loglow/TinyNES/README.md

# TinyNES
Classic NES games on open source hardware that fits in the palm of your hand

This work is licensed under a [Creative Commons Attribution-ShareAlike 4.0 International License](http://creativecommons.org/licenses/by-sa/4.0/).
