loglow/TinyNES/Packaging/TinyNES_Cart_Latch_Label.png

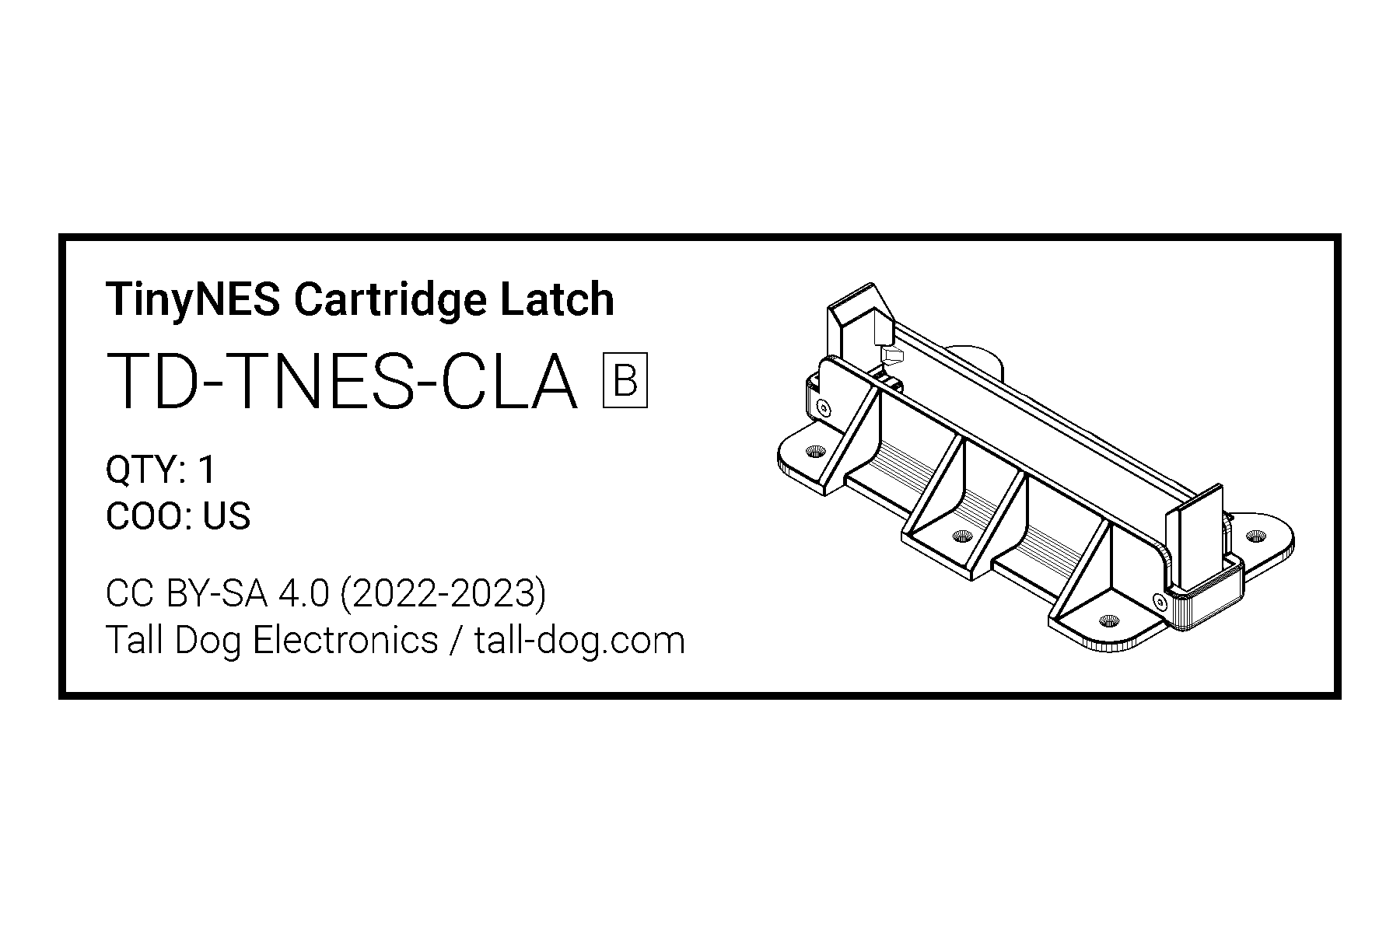
Packaging/TinyNES_Cart_Latch_Label.png
