loglow/TinyNES/Packaging/TinyNES_Famicom_Adapter_Label.png

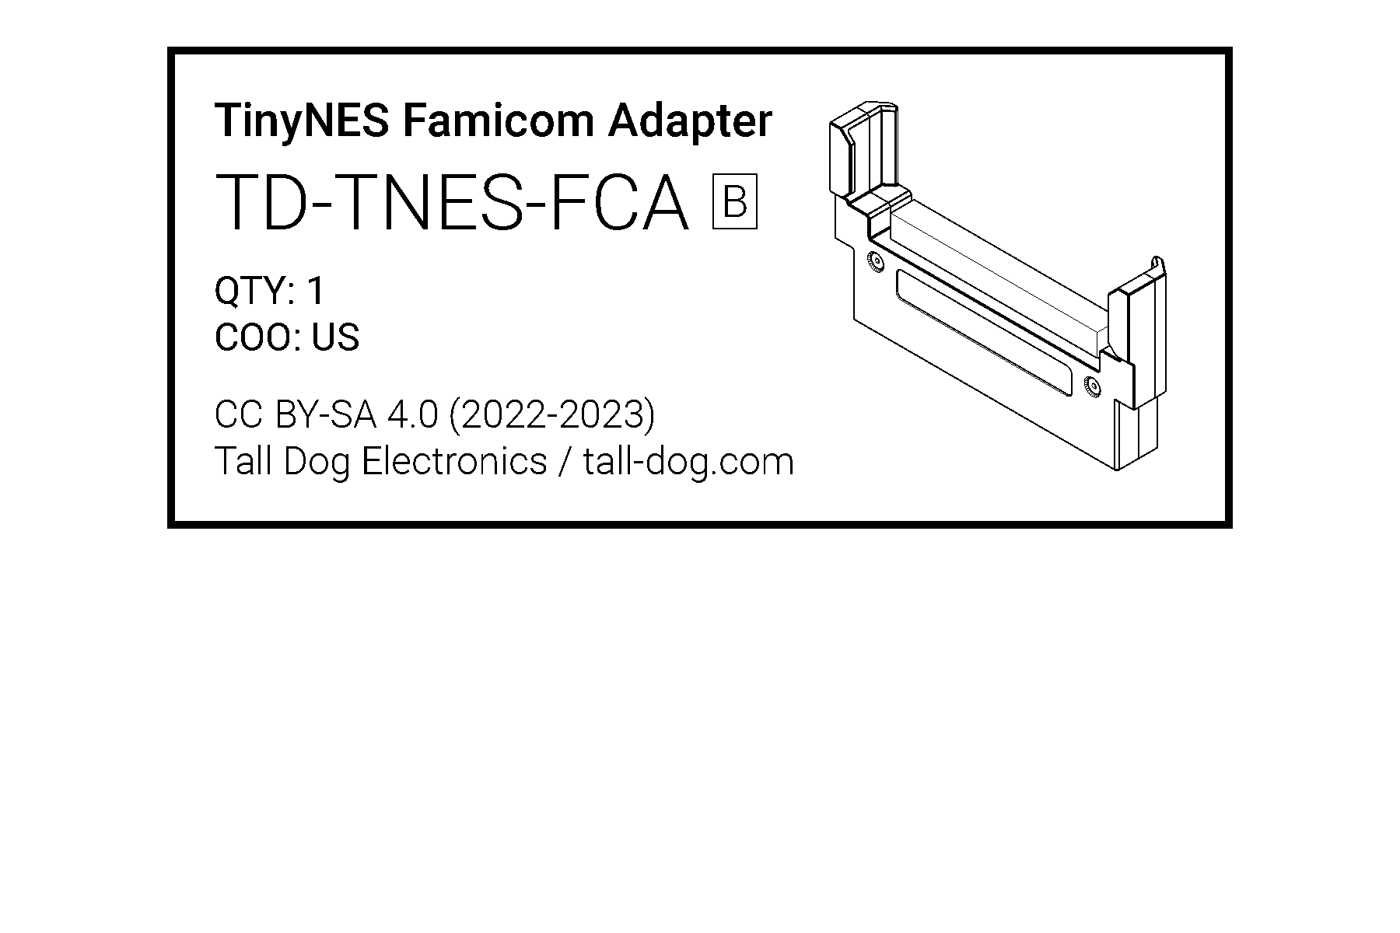
Packaging/TinyNES_Famicom_Adapter_Label.png
