loglow/TinyNES/Main Board/TinyNES_Main_Board_BOM.csv

Ref | Qty | Desc | Mfg | MPN
C1 C5 C11 C12 C13 | 5 | CAP CER 1UF 10V X7R 0805 | Samsung Electro-Mechanics | CL21B105KPFNNNE
C2 C3 C6 C7 C8 C9 C14 C17 C18 C24 C33 C38 | 12 | CAP CER 0.1UF 50V X7R 0805 | Samsung Electro-Mechanics | CL21B104KBCNNNC
C4 | 1 | CAP CER 10000PF 50V X7R 0805 | Samsung Electro-Mechanics | CL21B103KBANNNC
C10 C16 | 2 | CAP FILM 0.47UF 20% 16VDC 1206 | Panasonic Electronic Components | ECP-U1C474MA5
C15 | 1 | CAP ALUM 10UF 20% 16V SMD | Würth Elektronik | 865080340001
C19 C20 C21 C23 C26 C30 C34 C37 C39 | 9 | CAP CER 330PF 50V C0G/NPO 0805 | YAGEO | CC0805JRNPO9BN331
C22 | 1 | CAP TANT 10UF 10% 16V 1206 | KYOCERA AVX | TAJA106K016RNJ
C25 | 1 | DO NOT POPULATE | DNP | DNP
C27 C28 C29 | 3 | CAP FILM 1UF 20% 16VDC 1210 | Panasonic Electronic Components | ECP-U1C105MA5
C31 | 1 | CAP ALUM 220UF 20% 10V SMD | Nichicon | UWX1A221MCL1GB
C32 | 1 | CAP ALUM 100UF 20% 10V SMD | Panasonic Electronic Components | EEE-HA1A101WP
C35 | 1 | CAP CER 560PF 50V C0G/NPO 0805 | YAGEO | CC0805JRNPO9BN561
C36 | 1 | CAP CER 4.7UF 16V X7R 0805 | Murata Electronics | GRM21BR71C475KE51L
D1 | 1 | LED COOL WHITE CLEAR 5MM T/H | CreeLED, Inc. | C535A-WJN-CU0W0231
DA1 DA3 | 2 | DIODE ARRAY GP 80V 100MA UMD6 | Rohm Semiconductor | UMP11NTN
DA2 DA4 | 2 | DIODE ARRAY GP 80V 100MA UMD6 | Rohm Semiconductor | UMN11NTN
DA5 | 1 | DIODE ARRAY GP 180V 200MA SOT23 | Micro Commercial Co | MMBD1503-TP
H1 | 1 | CONN CARDEDGE 72POS 2.50MM | Xunbeifang | GNI06700
H2 H3 H4 | 3 | CONN RCPT 3POS 0.1 GOLD PCB | Samtec Inc. | SLW-103-01-F-S
H5 H6 | 2 | CONN HEADER VERT 7POS 2MM | Adam Tech | 2SH-C-07-TS
J1 | 1 | CONN RCA JACK MONO 3.2MM R/A | CUI Devices | RCJ-044
J2 | 1 | CONN RCA JACK MONO 3.2MM R/A | CUI Devices | RCJ-042
J3 | 1 | CONN JACK 4COND 3.5MM R/A | CUI Devices | SJ-43514
J4 | 1 | CONN RCPT TYPE C 6P SMD RA | GCT | USB4125-GF-A
P1 | 1 | TRIM 100K OHM 0.5W GW TOP ADJ | Bourns Inc. | 3361P-1-104GLF
Q1 | 1 | TRANS PNP 40V 200MA TO236AB | Nexperia USA Inc. | PMBT3906,235
R1 | 1 | RES 100K OHM 1% 1/8W 0805 | Stackpole Electronics Inc | RMCF0805FT100K
R2 R15 R16 R17 R18 | 5 | RES 10K OHM 1% 1/8W 0805 | YAGEO | RC0805FR-0710KL
R3 R4 R5 | 3 | RES 30 OHM 1% 1/8W 0805 | YAGEO | RC0805FR-0730RL
R6 R11 | 2 | RES 12K OHM 0.5% 1/8W 0805 | Panasonic Electronic Components | ERA-6AED123V
R7 R9 | 2 | RES 68 OHM 1% 1/8W 0805 | YAGEO | RT0805FRE0768RL
R8 | 1 | RES 20K OHM 1% 1/4W 0805 | Stackpole Electronics Inc | RNCP0805FTD20K0
R10 R12 R13 | 3 | RES 22K OHM 1% 1/8W 0805 | YAGEO | RT0805FRE0722KL
R14 | 1 | RES 80.6K OHM 0.1% 1/8W 0805 | Panasonic Electronic Components | ERA-6AEB8062V
R19 | 1 | RES 300 OHM 1% 1/8W 0805 | YAGEO | RC0805FR-07300RL
R20 | 1 | RES 270 OHM 1% 1/8W 0805 | YAGEO | RC0805FR-07270RL
R21 | 1 | RES 110 OHM 5% 1/8W 0805 | Panasonic Electronic Components | ERJ-6GEYJ111V
R22 | 1 | RES 150 OHM 0.1% 1/8W 0805 | YAGEO | RT0805BRD07150RL
R23 R24 | 2 | RES 5.1K OHM 1% 1/8W 0805 | YAGEO | RC0805FR-075K1L
R25 R26 R27 R28 | 4 | RES 10K OHM 1% 1/10W 0603 | YAGEO | RC0603FR-0710KL
RA1 | 1 | RES ARRAY 8 RES 10K OHM 2512 | Panasonic Electronic Components | EXB-A10P103J
S1 S2 | 2 | SWITCH SLIDE DPDT 300MA 6V | C&K | JS202011JCQN
S3 | 1 | SWITCH TACTILE SPST-NO 0.05A 12V | C&K | PTS645VH83-2 LFS
S4 | 1 | SWITCH SLIDE SPDT 200MA 30V | E-Switch | EG1213
S5 | 1 | SWITCH SLIDE SPDT 300MA 4V | Nidec Copal Electronics | CUS-12TB
U1 U4 U18 | 3 | IC BUFFER INVERT 5.5V SOT23-5 | Texas Instruments | SN74LVC1G240DBVT
U2 | 1 | IC MEMS OSC XO 26.601712MHZ SMD | SiTime | SIT2001BC-S2-33N-26.601712
U3 | 1 | IC CLK MULTIPLIER PLL 8-SOIC | Renesas Electronics America Inc | 501MLFT
U5 U6 | 2 | IC SRAM 256KBIT PARALLEL 28SOP | ISSI, Integrated Silicon Solution Inc | IS62C256AL-45ULI-TR
U7 | 1 | IC CLK BUFFER 1:3 150MHZ 6SOT23 | Microchip Technology | PL133-37TC
U8 | 1 | IC MEMS OSC XO 21.477270MHZ SMD | SiTime | SIT2001BC-S2-33N-21.477270
U9 | 1 | IC REG LINEAR 3.3V 300MA SOT23 | Diodes Incorporated | AP2127N-3.3TRG1
U10 U11 | 2 | IC FF D-TYPE SNGL 1BIT 8TSSOP | Nexperia USA Inc. | 74LVC1G74DP,125
U12 | 1 | IC LINE DRIVER 14TSSOP | onsemi | NCS603DTBR2G
U13 | 1 | IC LATCH TRANSP OCTAL D 20SO | Texas Instruments | SN74ALS373ANSR
U14 U16 | 2 | IC DIP SOCKET 40POS MACHINED GOLD | Phoenix Enterprises | HWS2632
U15 | 1 | IC DECODER/DEMUX 1X2:4 16SOIC | Texas Instruments | SN74LS139ADR
U17 | 1 | IC BUFFER INVERT 5.5V 20SO | Texas Instruments | SN74AHC240NSR
U19 | 1 | IC SUPERVISOR 1 CHANNEL SOT143 | Diodes Incorporated | APX811-46UG-7
U20 | 1 | IC PWR SWITCH P-CHAN 1:1 SOT23-5 | Microchip Technology | MIC2004-1.2YM5-TR
U21 | 1 | IC GATE NOR 1CH 2-INP 5TSOP | onsemi | MC74VHC1G02DTT1G
U22 | 1 | IC GATE XOR 1CH 2-INP 5TSOP | onsemi | MC74VHC1G86DTT1G
