loglow/TinyNES/Jumper Board/TinyNES_Jumper_Board_BOM.csv

Ref | Qty | Desc | Mfg | MPN
H1 H2 H3 | 3 | CONN HEADER VERT 3POS 2.54MM | Samtec Inc. | TSW-103-06-L-S
