loglow/TinyNES/Famicom Adapter/TinyNES_Famicom_Adapter_BOM.csv

Ref | Qty | Desc | Mfg | MPN
H1 | 1 | CARDEDGE FEMALE 60POS 2.54MM | WingTAT | S-60M-2.54-5
