loglow/TinyNES/RGB Board/TinyNES_RGB_Board_XYR.csv

Ref | X | Y | R
C1 | 34.93 | 8.13 | 180
C2 | 46.36 | 6.1 | 270
R1 | 40.64 | 4.06 | 90
R2 | 25.65 | 4.06 | 90
R3 | 16.51 | 4.06 | 270
U1 | 34.93 | 3.94 | 90
