loglow/TinyNES/Packaging/TinyNES_Foam_Cutout_A.step

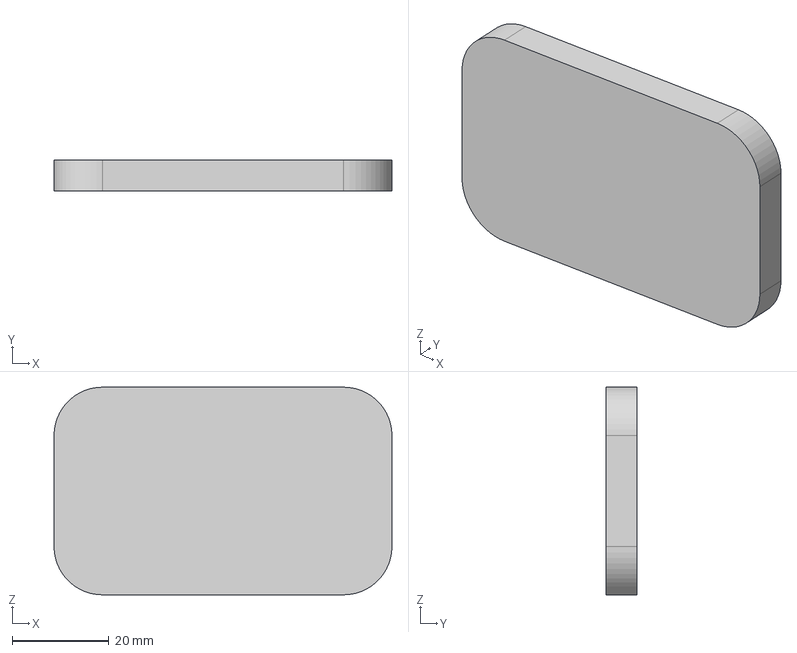
[picture p3: CAD file, 2022-03-21]
Packaging/TinyNES_Foam_Cutout_A.step
70.0 x 6.35 x 43.0 mm
