loglow/TinyNES/Plastic Parts/TinyNES_Cart_Latch_Lever_Left.step

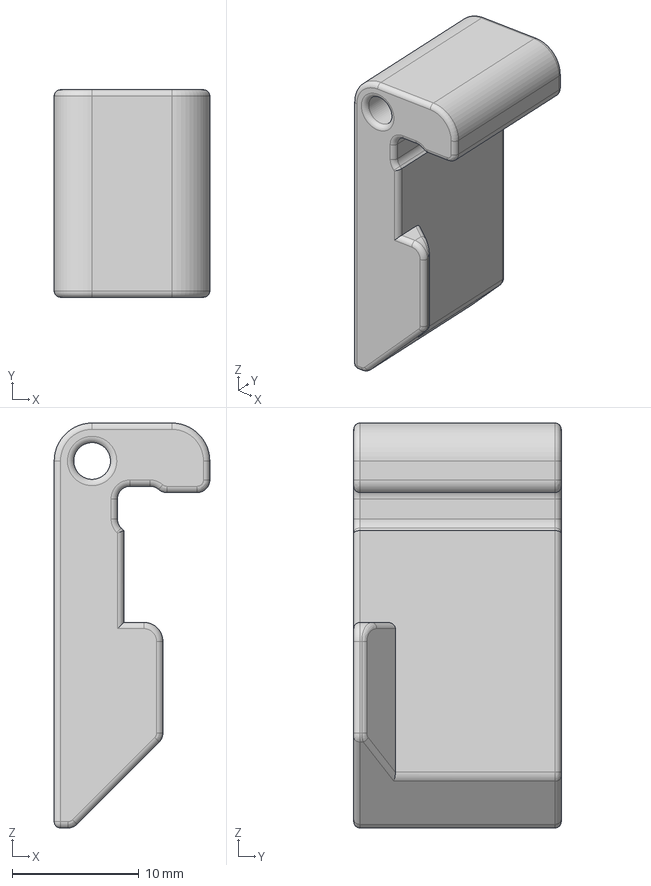
[picture p4: CAD file, 2024-04-02]
Plastic Parts/TinyNES_Cart_Latch_Lever_Left.step
12.3 x 16.4 x 32.0 mm
