loglow/TinyNES/RGBS to YPbPr/RGBS_to_YPbPr_Enclosure_Bottom.stl

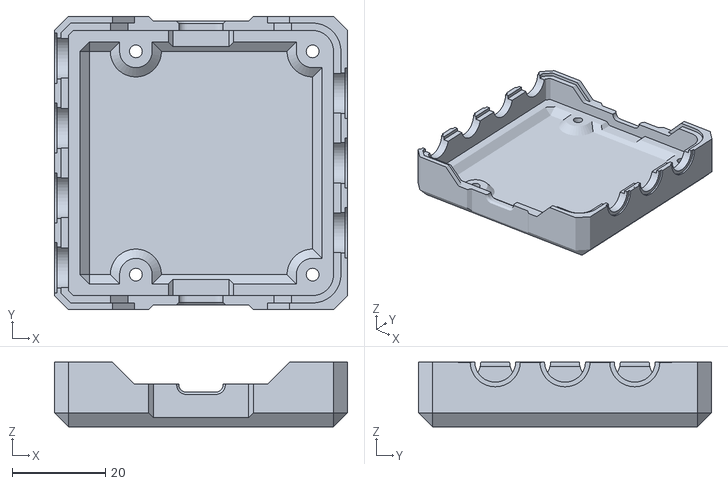
[picture p5: CAD file, 2024-04-02]
RGBS to YPbPr/RGBS_to_YPbPr_Enclosure_Bottom.stl
63.0 x 63.0 x 13.9
