loglow/TinyNES/Packaging/TinyNES_Foam_Top.step

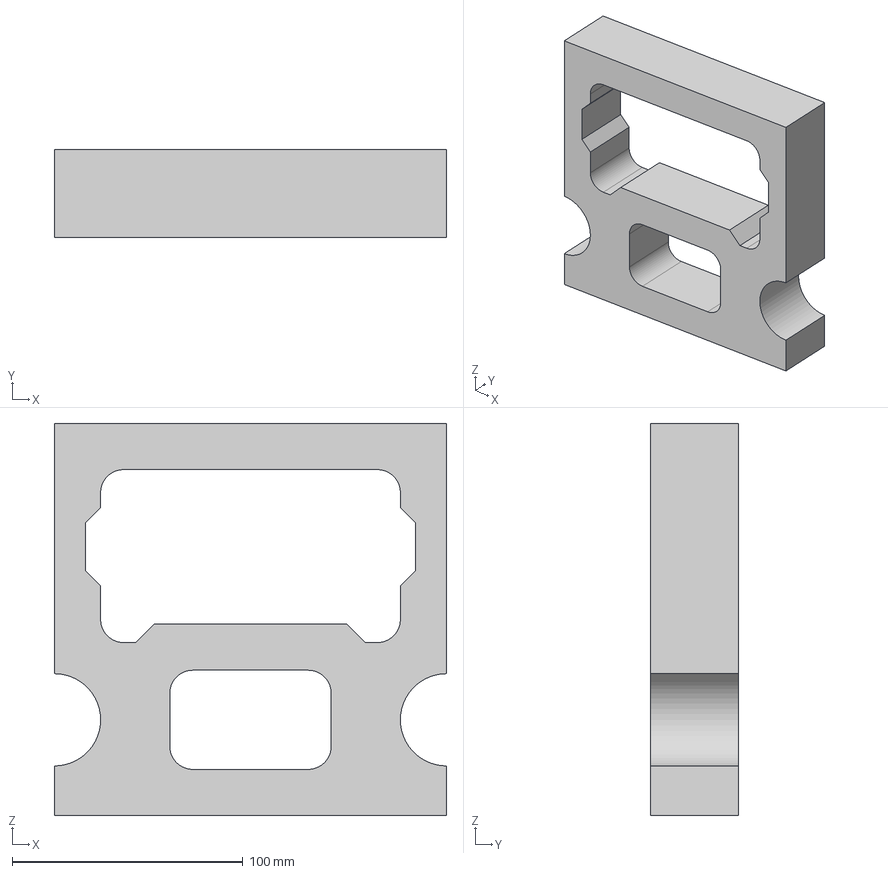
[picture p6: CAD file, 2022-03-21]
Packaging/TinyNES_Foam_Top.step
170.0 x 38.1 x 170.0 mm
