loglow/TinyNES/Plastic Parts/TinyNES_Famicom_Adapter_Front.step

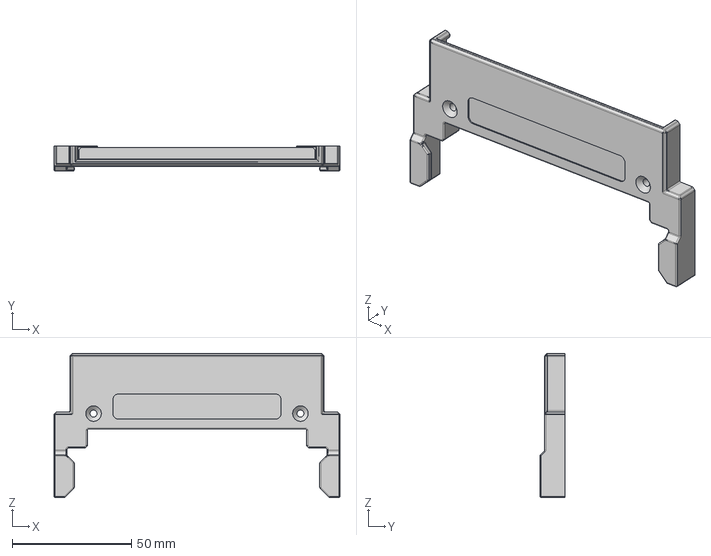
[picture p7: CAD file, 2024-04-02]
Plastic Parts/TinyNES_Famicom_Adapter_Front.step
120.0 x 10.6 x 60.5 mm
