loglow/TinyNES/RGBS to YPbPr/RGBS_to_YPbPr_Enclosure_Top.stl

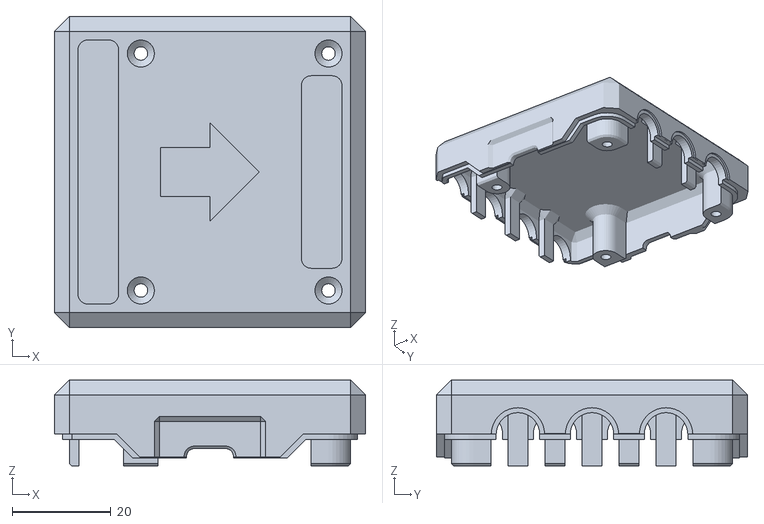
[picture p8: CAD file, 2024-04-02]
RGBS to YPbPr/RGBS_to_YPbPr_Enclosure_Top.stl
63.0 x 63.0 x 17.4
