loglow/TinyNES/Packaging/TinyNES_Foam_Cutout_B.step

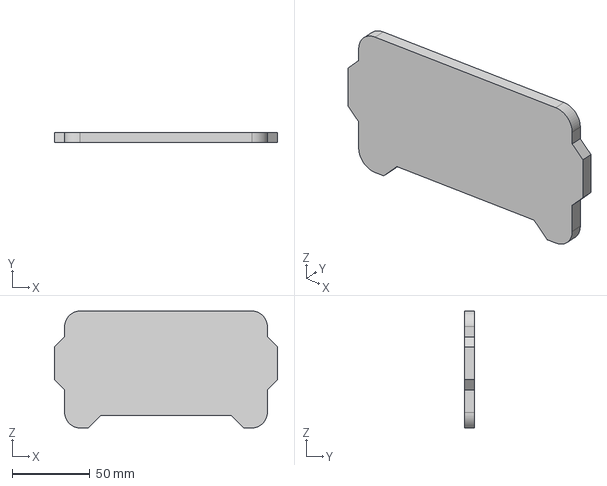
[picture p9: CAD file, 2022-03-21]
Packaging/TinyNES_Foam_Cutout_B.step
143.0 x 6.35 x 75.0 mm
