loglow/TinyNES/Packaging/TinyNES_Foam_Bottom.step

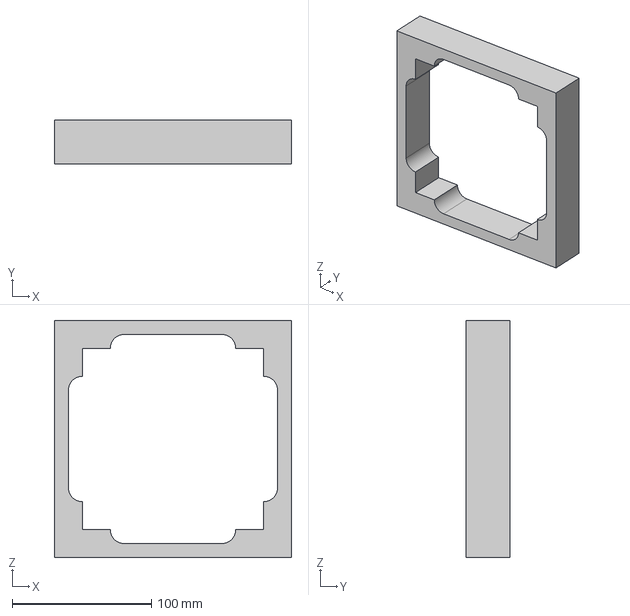
[picture p10: CAD file, 2022-03-21]
Packaging/TinyNES_Foam_Bottom.step
170.0 x 31.8 x 170.0 mm
