loglow/TinyNES/Plastic Parts/TinyNES_Jumper_Spacer.stl

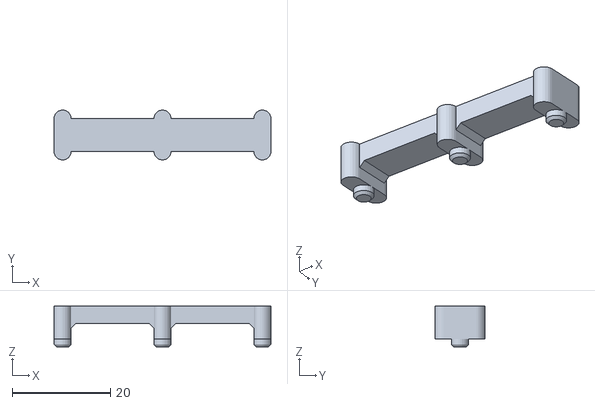
[picture p11: CAD file, 2024-04-02]
Plastic Parts/TinyNES_Jumper_Spacer.stl
44.1 x 10.2 x 8.29
