loglow/TinyNES/Plastic Parts/TinyNES_Cart_Latch_Body.step

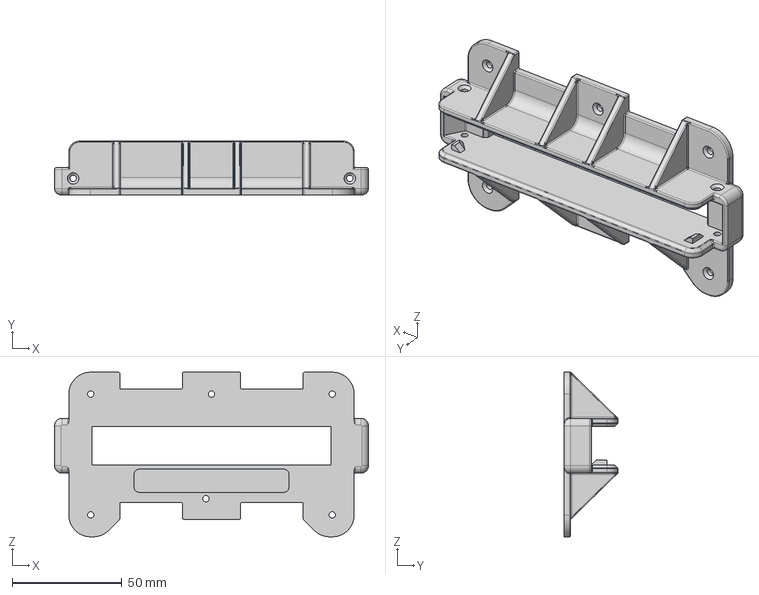
[picture p12: CAD file, 2024-04-02]
Plastic Parts/TinyNES_Cart_Latch_Body.step
143.0 x 24.5 x 75.0 mm
