loglow/TinyNES/Plastic Parts/TinyNES_RGB_Spacer.stl

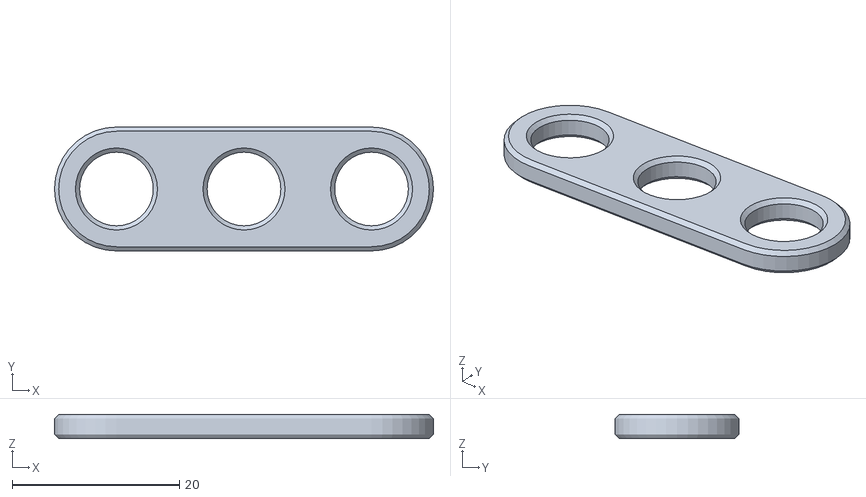
[picture p13: CAD file, 2022-07-28]
Plastic Parts/TinyNES_RGB_Spacer.stl
45.3 x 14.8 x 2.89
