loglow/TinyNES/Plastic Parts/TinyNES_Cart_Guide.step

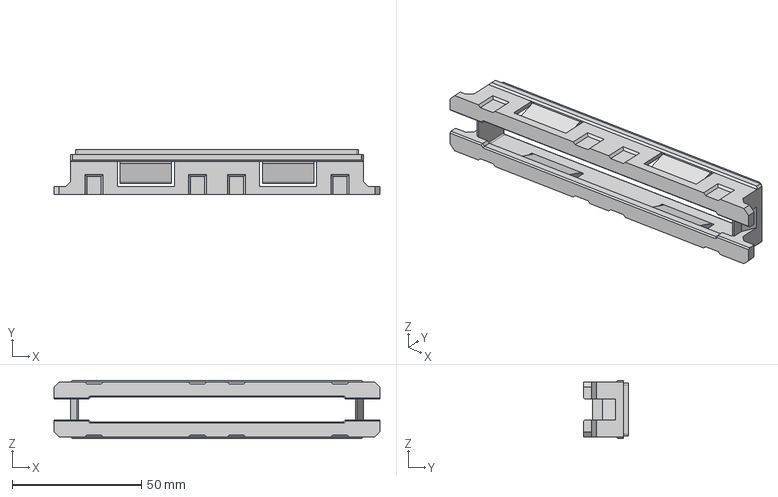
[picture p14: CAD file, 2022-03-21]
Plastic Parts/TinyNES_Cart_Guide.step
126.0 x 17.4 x 22.6 mm
