loglow/TinyNES/Plastic Parts/TinyNES_Shoulder_Washer.step

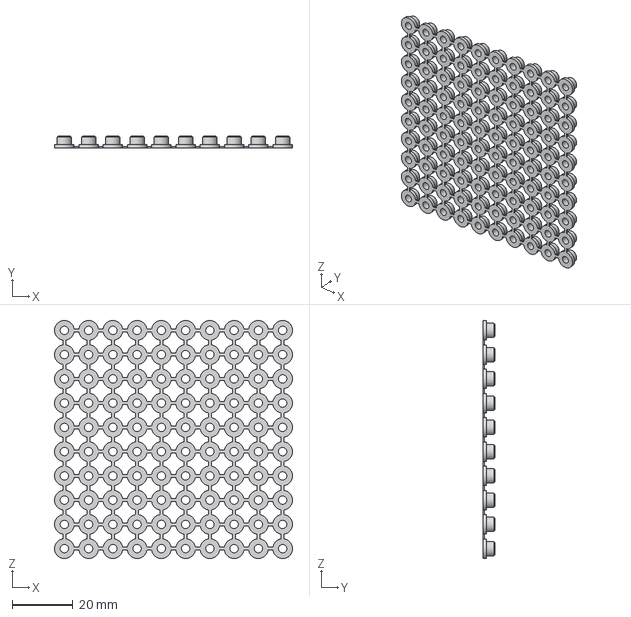
[picture p15: CAD file, 2022-03-21]
Plastic Parts/TinyNES_Shoulder_Washer.step
78.5 x 3.95 x 78.5 mm
