loglow/TinyNES/(list of files, cad)

Other CAD files:
Plastic Parts/TinyNES_Cart_Latch_Lever_Right.step
Plastic Parts/TinyNES_Famicom_Adapter_Back.step
Controller Board/NES_Controller_Board_Model.skp
Packaging/TinyNES_Foam_Bottom.f3d
Packaging/TinyNES_Foam_Cutout_A.f3d
Packaging/TinyNES_Foam_Cutout_B.f3d
Packaging/TinyNES_Foam_Top.f3d
Plastic Parts/TinyNES_Cart_Guide.f3d
Plastic Parts/TinyNES_Cart_Latch_Body.f3d
Plastic Parts/TinyNES_Cart_Latch_Lever.f3d
Plastic Parts/TinyNES_Famicom_Adapter.f3d
Plastic Parts/TinyNES_Shoulder_Washer.f3d
RGBS to YPbPr/RGBS_to_YPbPr_Model.skp
