loglow/TinyNES/(threads)

Thread 1 (2025-01-24):

Enclosure

FranTerrassa, 2025-01-24:
Hi, great job!!! and thanks for sharing it with the community. Could the enclosure be made in 1.6 mm? Manufacturing it in black and in 2 mm would greatly increase the production costs of the PCB. Thanks in advance and best regards.

loglow, 2025-01-24:
Hi @FranTerrassa

I wouldn't recommend 1.6 mm material without majorly redesigning the panels. It is much less rigid and the panels will not align properly if they're thinner.

However, I do recommend PCBX (https://www.pcbx.com/) for fabrication, since their additional charges for matte black, 2.0 mm thickness, and ENIG are all very minimal compared to other PCB manufacturers.

Alternately, if you're only looking for one (or a small number) of enclosures, I can probably provide them. Feel free to reach out to me at dan@tall-dog.com

All the best,
Dan

Closed 2025-01-24.
