loglow/TinyNES/Main Board/TinyNES_Main_Board_Schematic.pdf

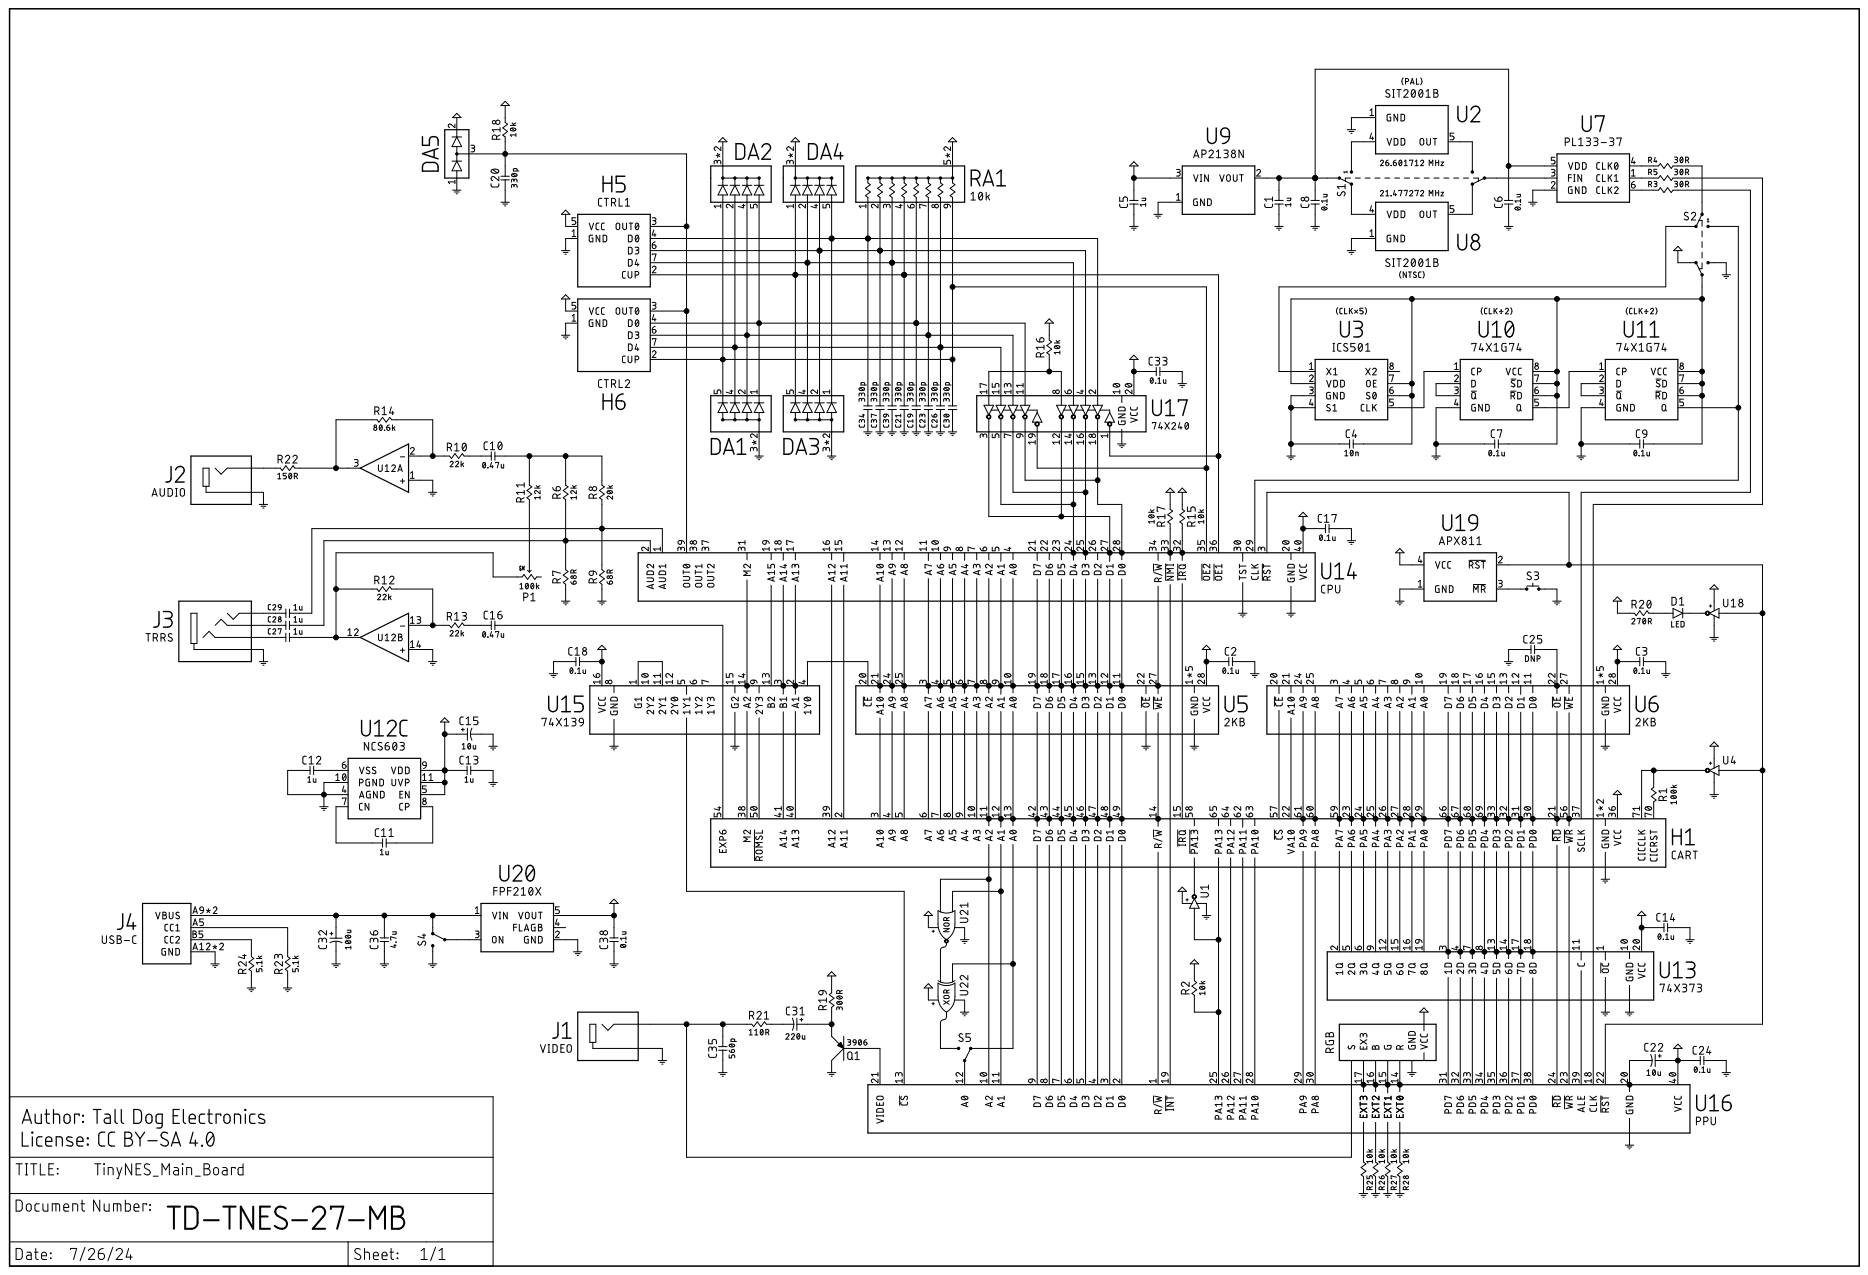
[picture p20: page 1]
