loglow/TinyNES/Main Board/TinyNES_Main_Board_Assembly.pdf

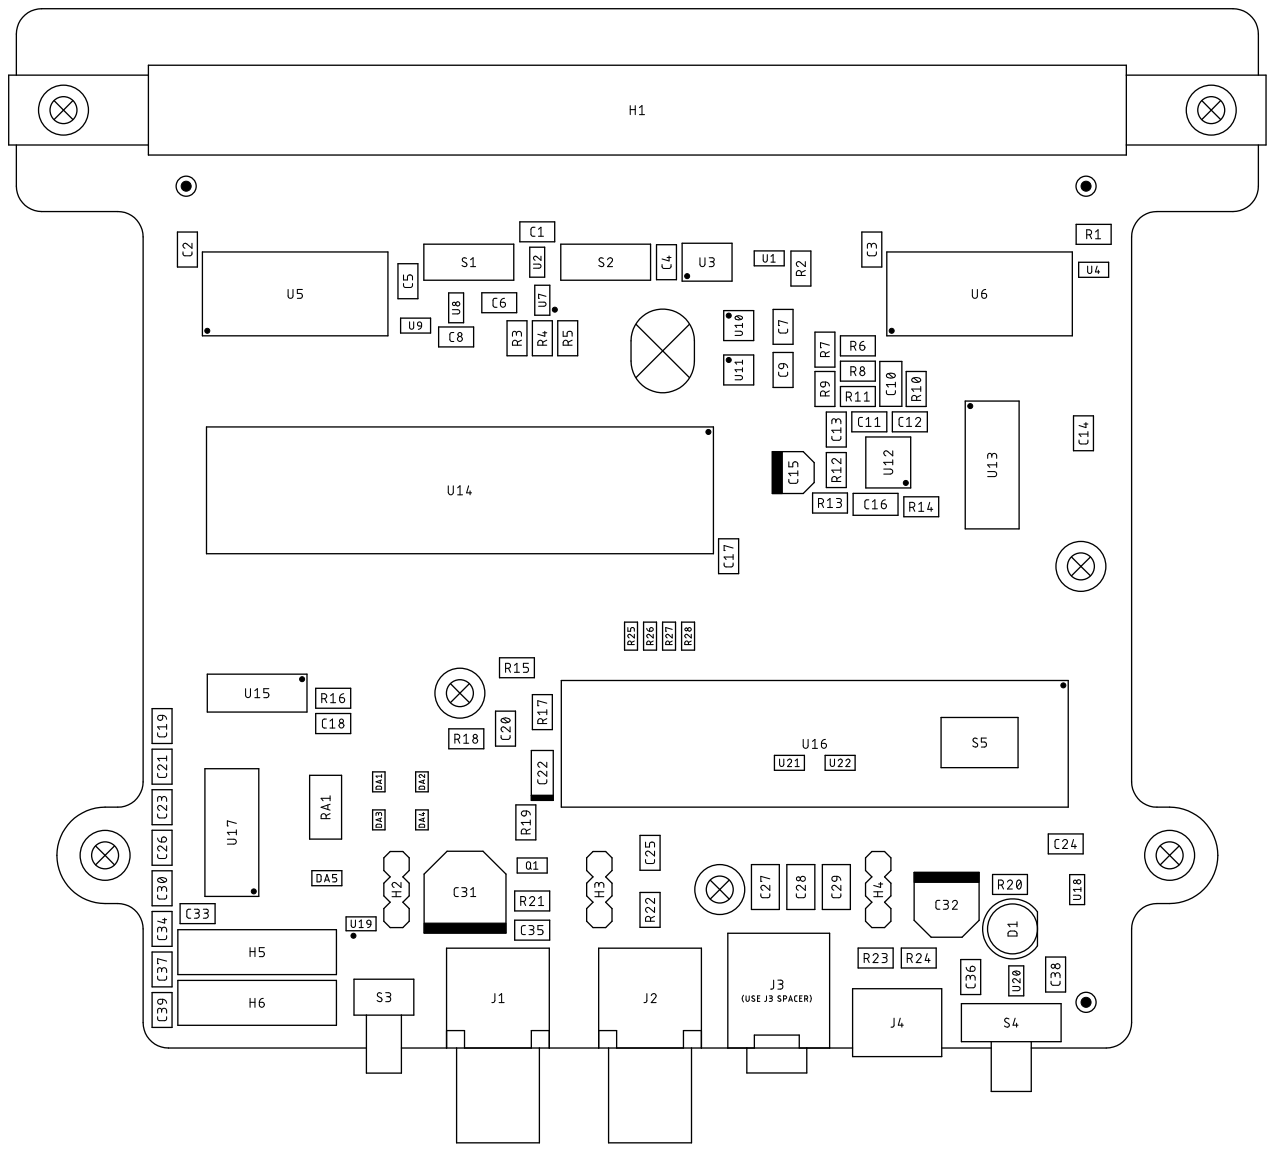
[picture p21: page 1]

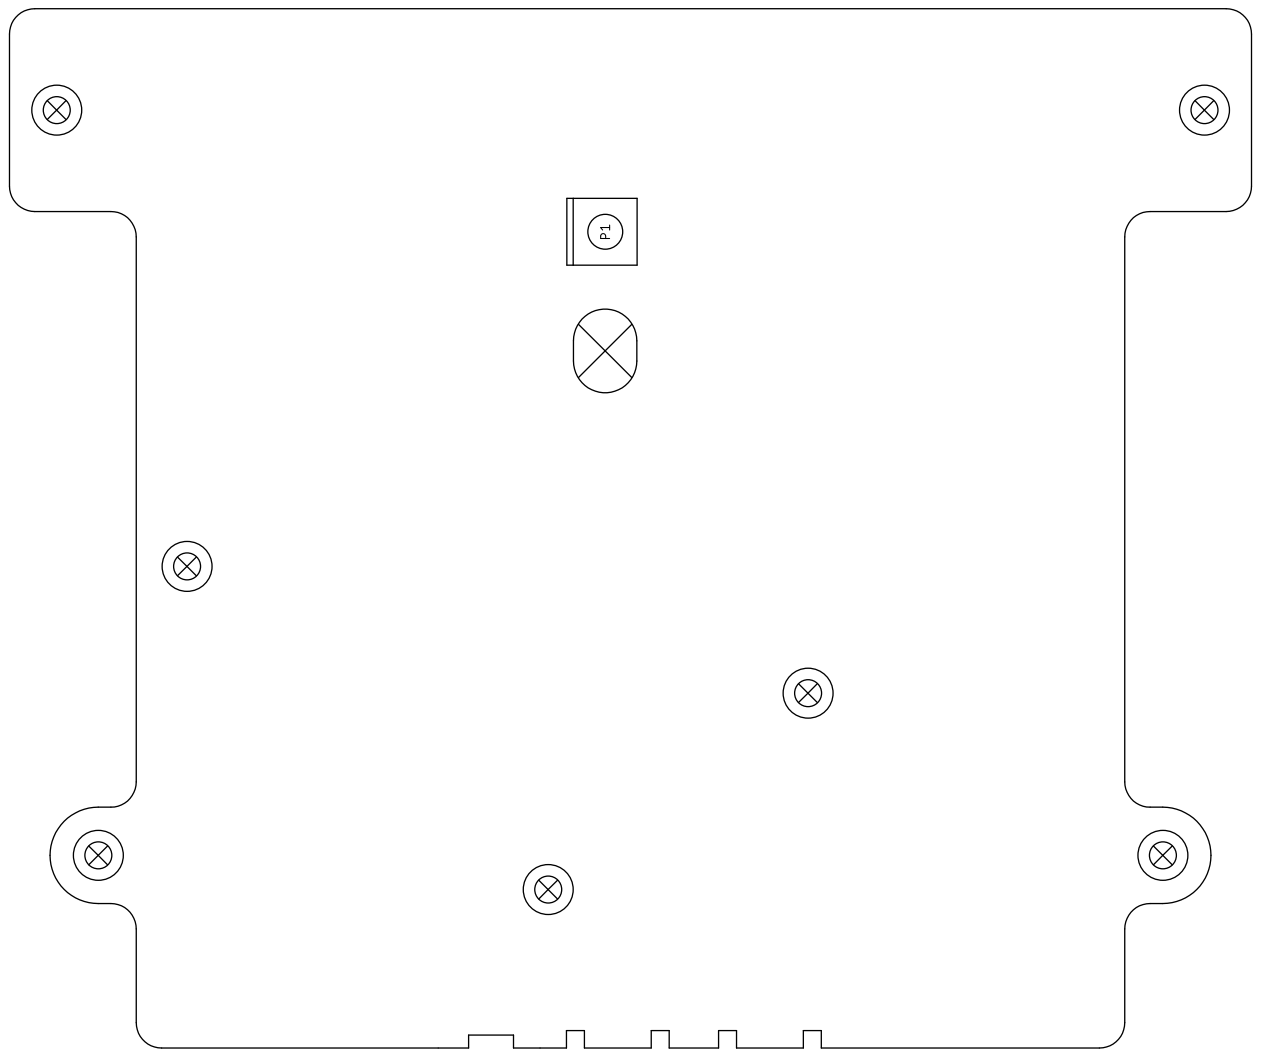
[picture p22: page 2]
