loglow/TinyNES/RGBS to YPbPr/RGBS_to_YPbPr_Assembly.pdf

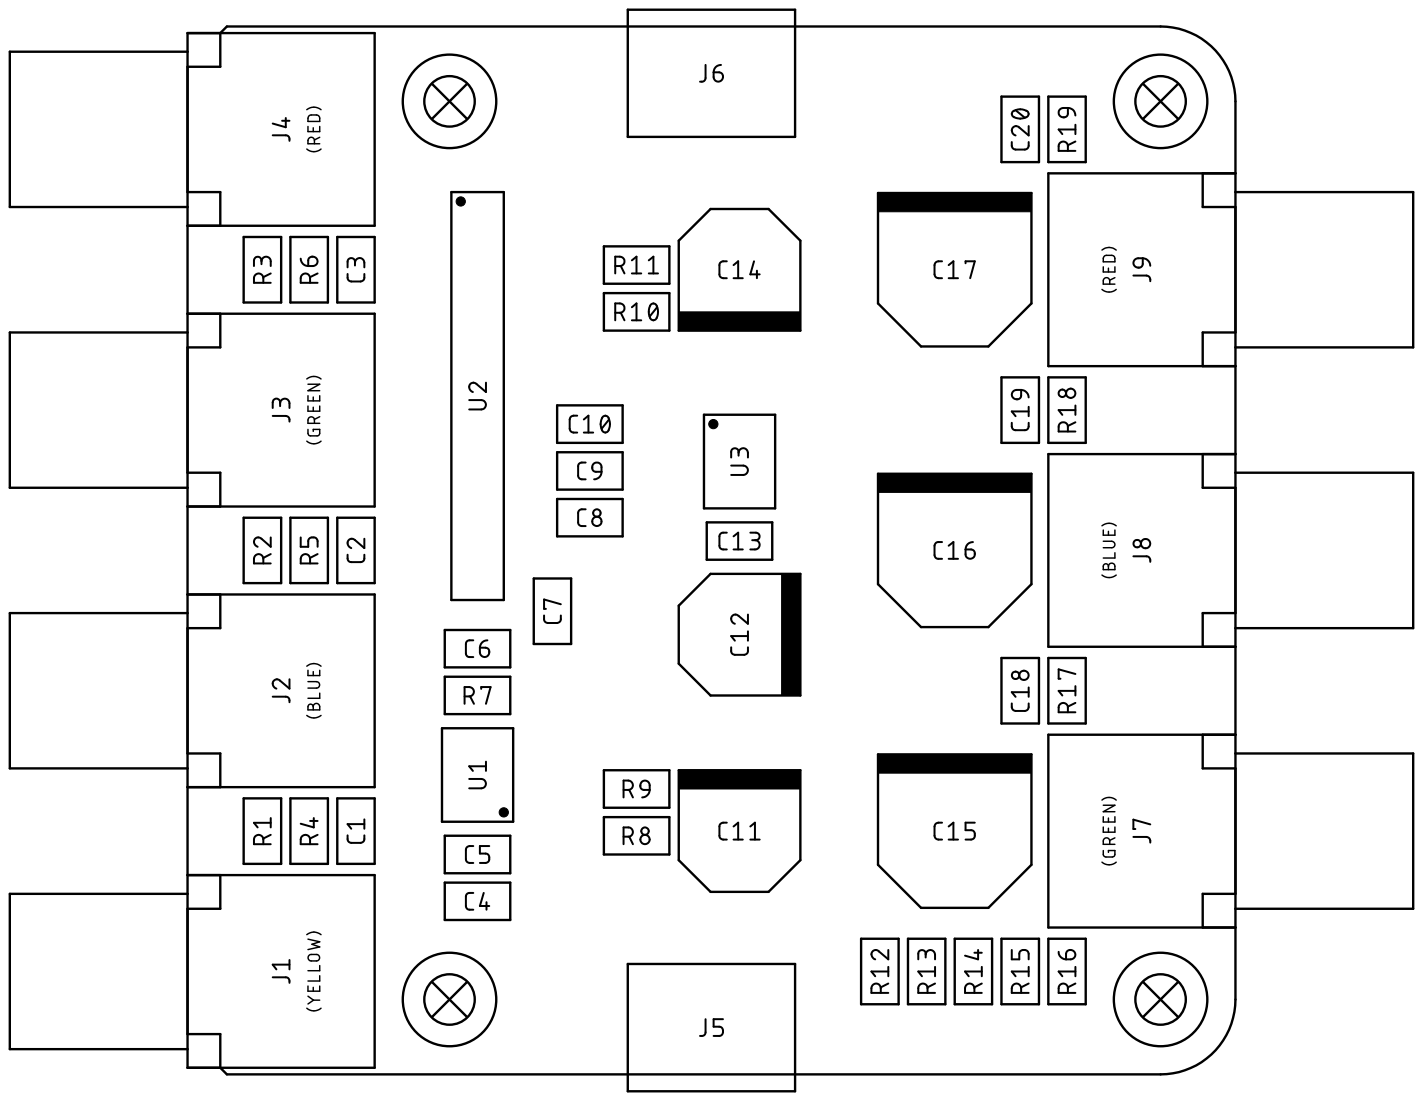
[picture p23: page 1]
