loglow/TinyNES/RGBS to YPbPr/RGBS_to_YPbPr_Schematic.pdf

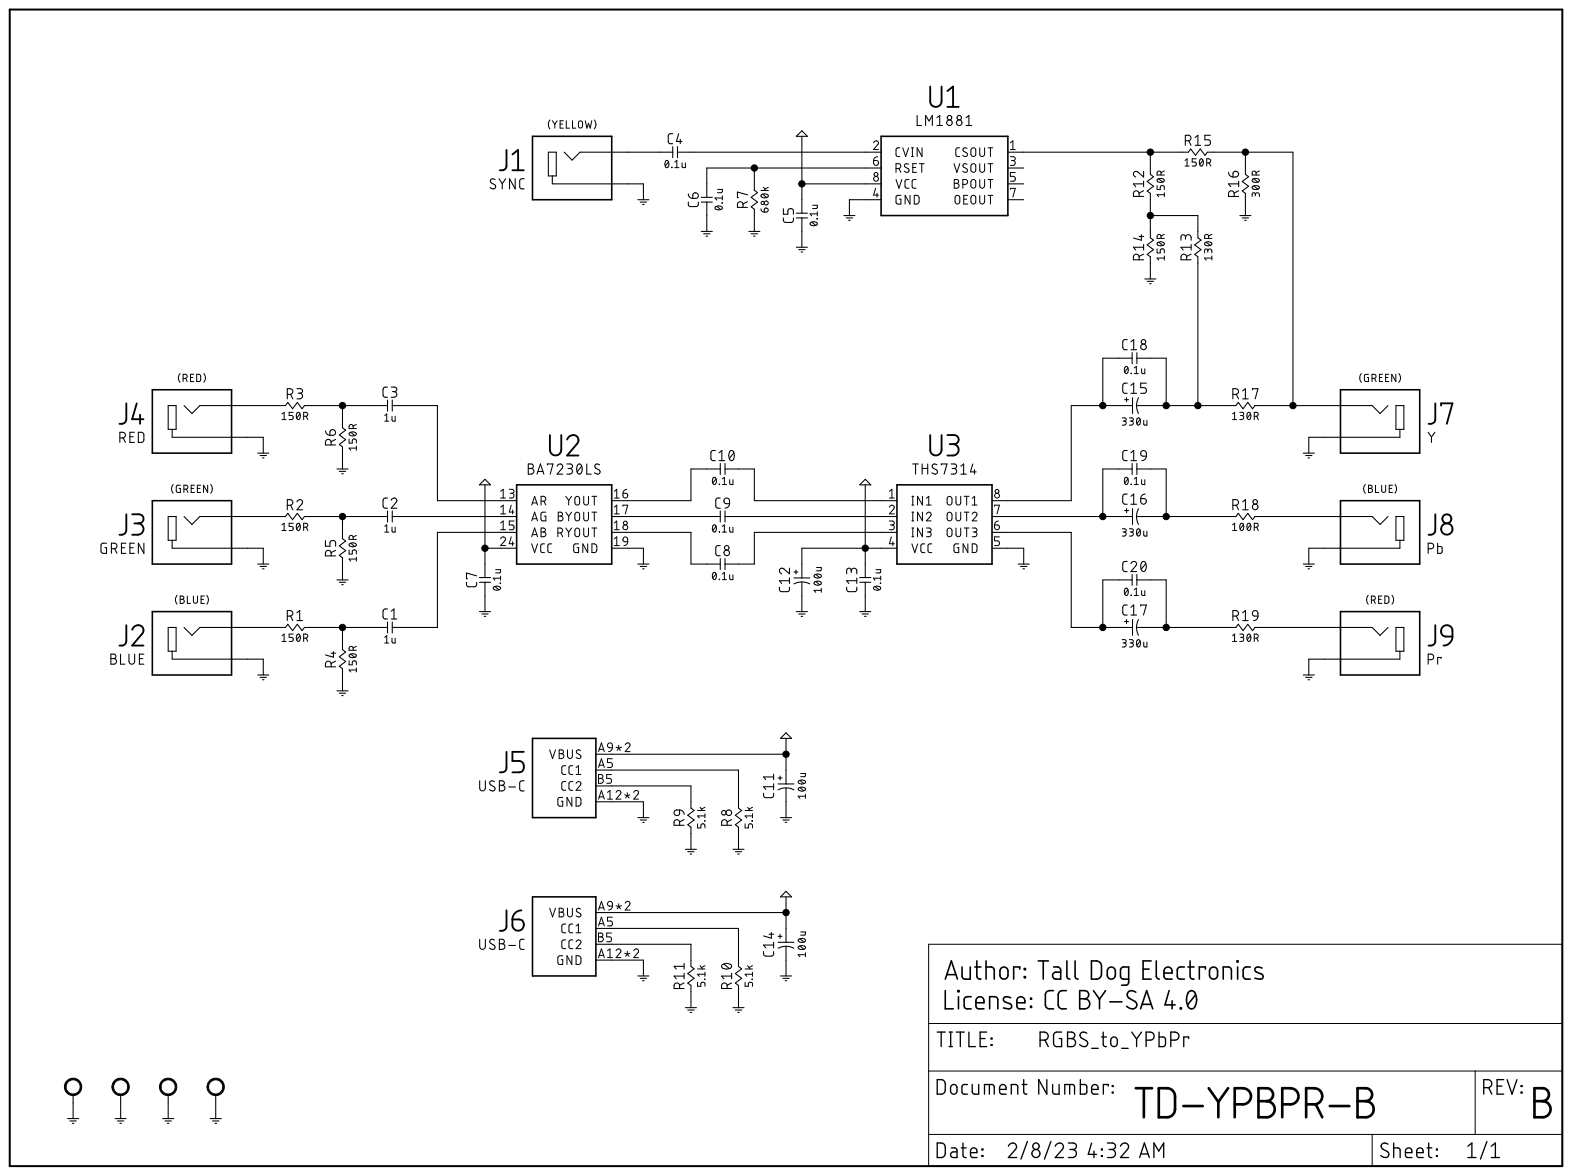
[picture p24: page 1]
