loglow/TinyNES/RGB Board/TinyNES_RGB_Board_Assembly.pdf

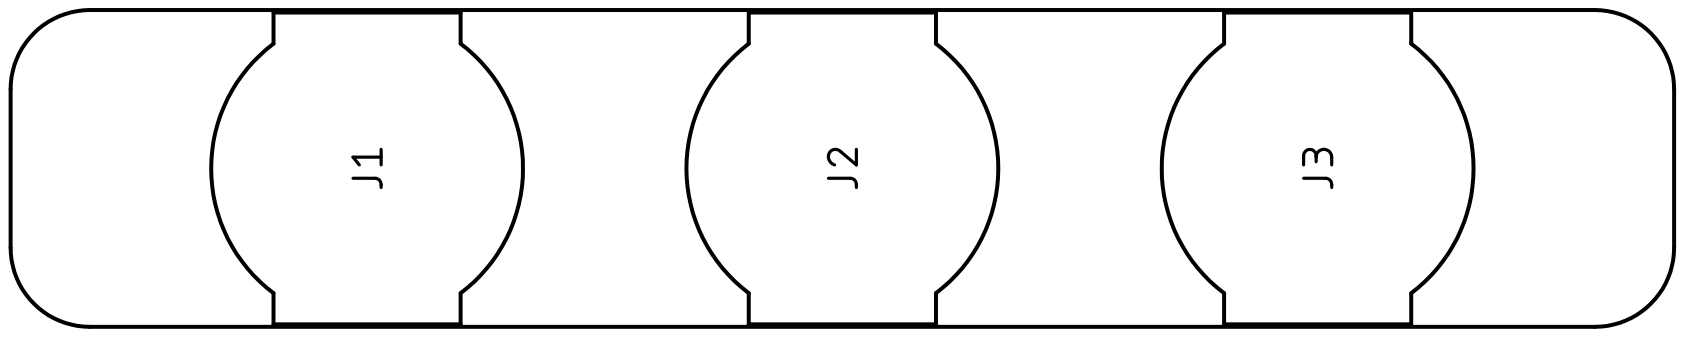
[picture p25: page 1]

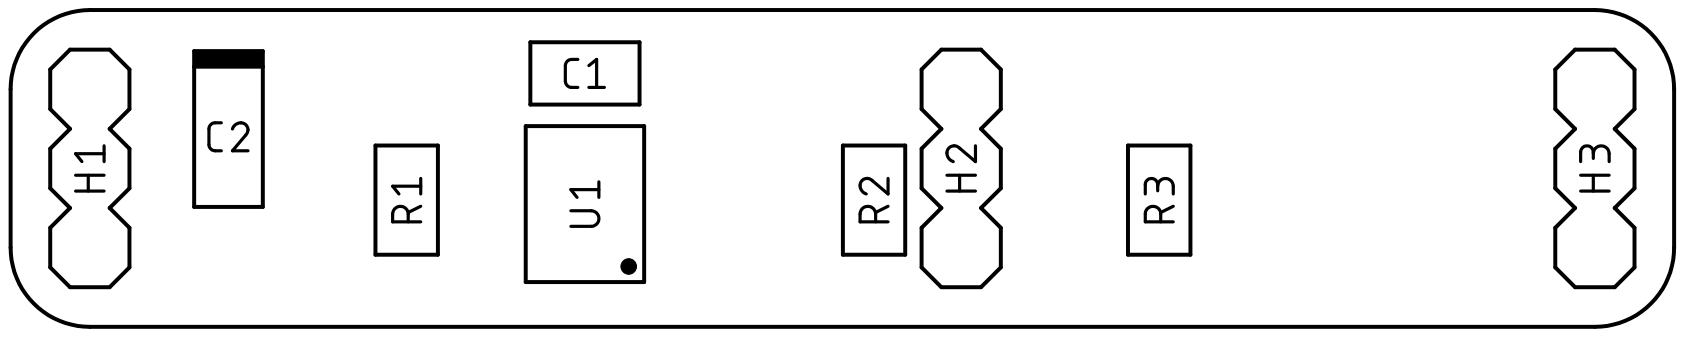
[picture p26: page 2]
