loglow/TinyNES/RGB Board/TinyNES_RGB_Board_Schematic.pdf

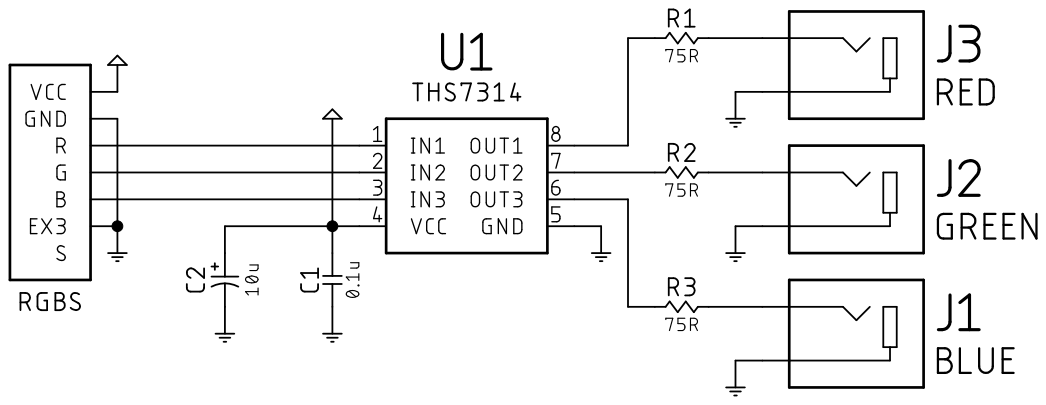
[picture p27: page 1]
