loglow/TinyNES/Controller Board/NES_Controller_Board_Schematic.pdf

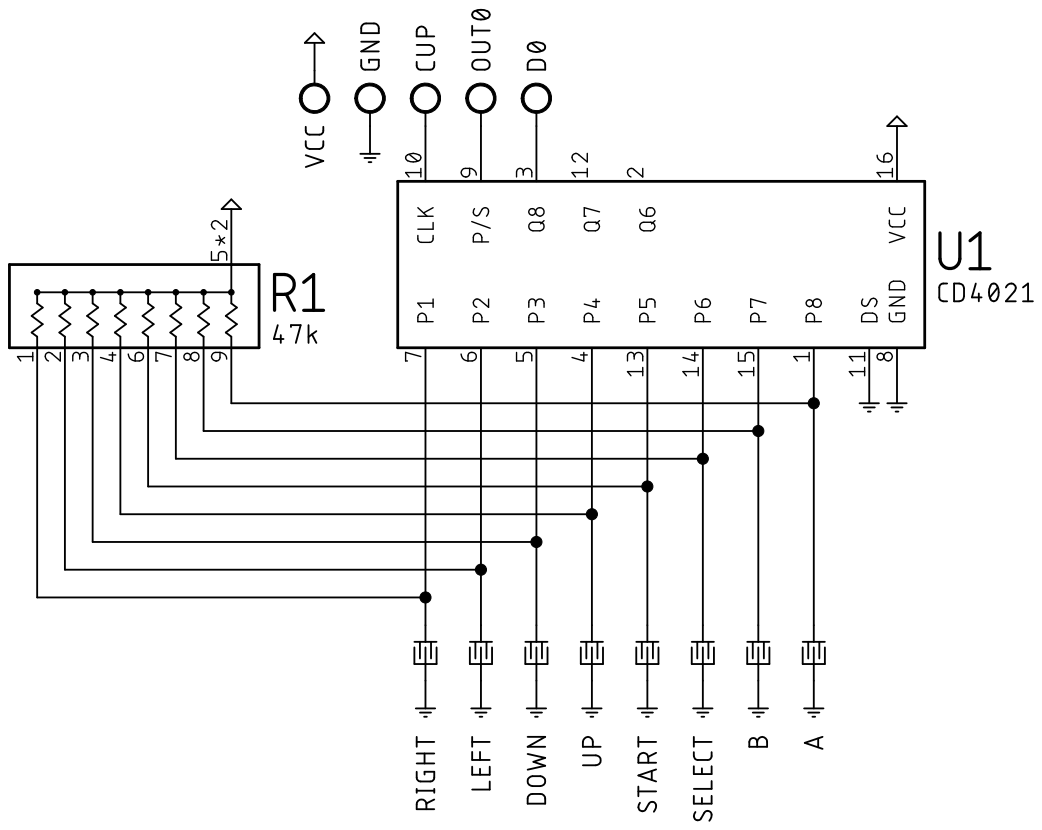
[picture p28: page 1]
