loglow/TinyNES/Controller Port/TinyNES_Controller_Port_Schematic.pdf

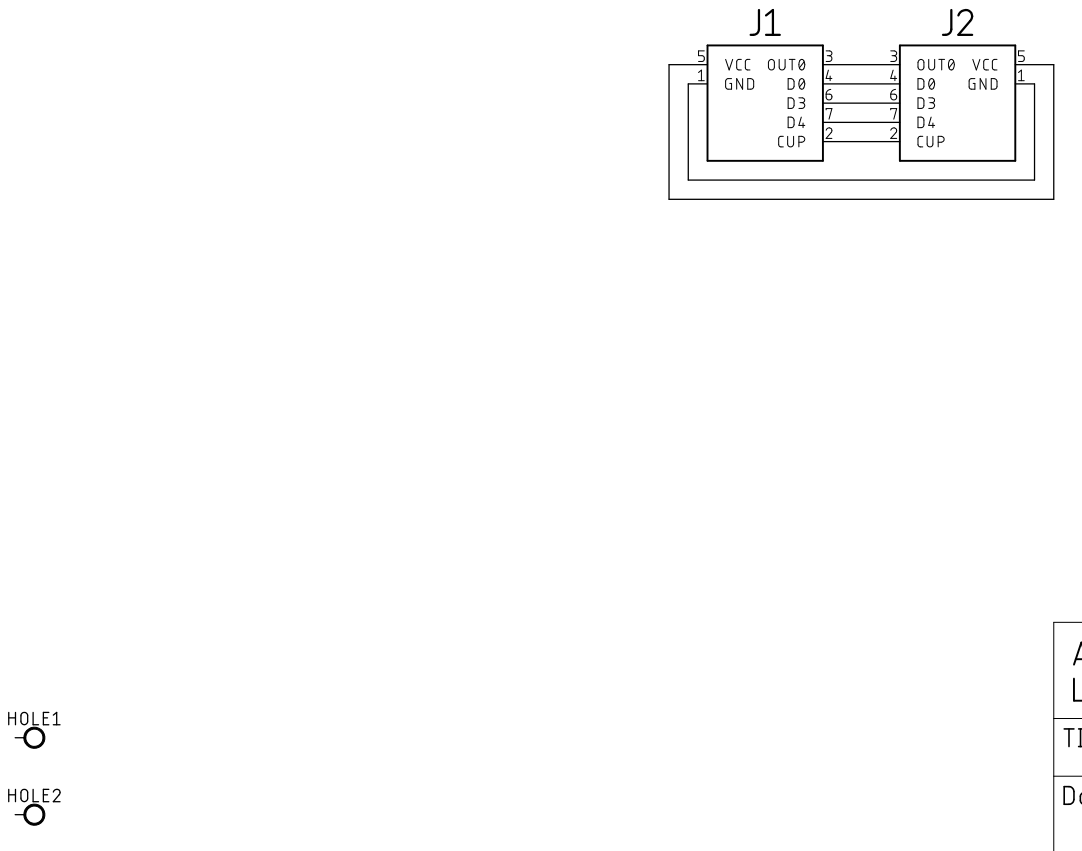
[picture p29: page 1]
