loglow/TinyNES/Famicom Adapter/TinyNES_Famicom_Adapter_Schematic.pdf

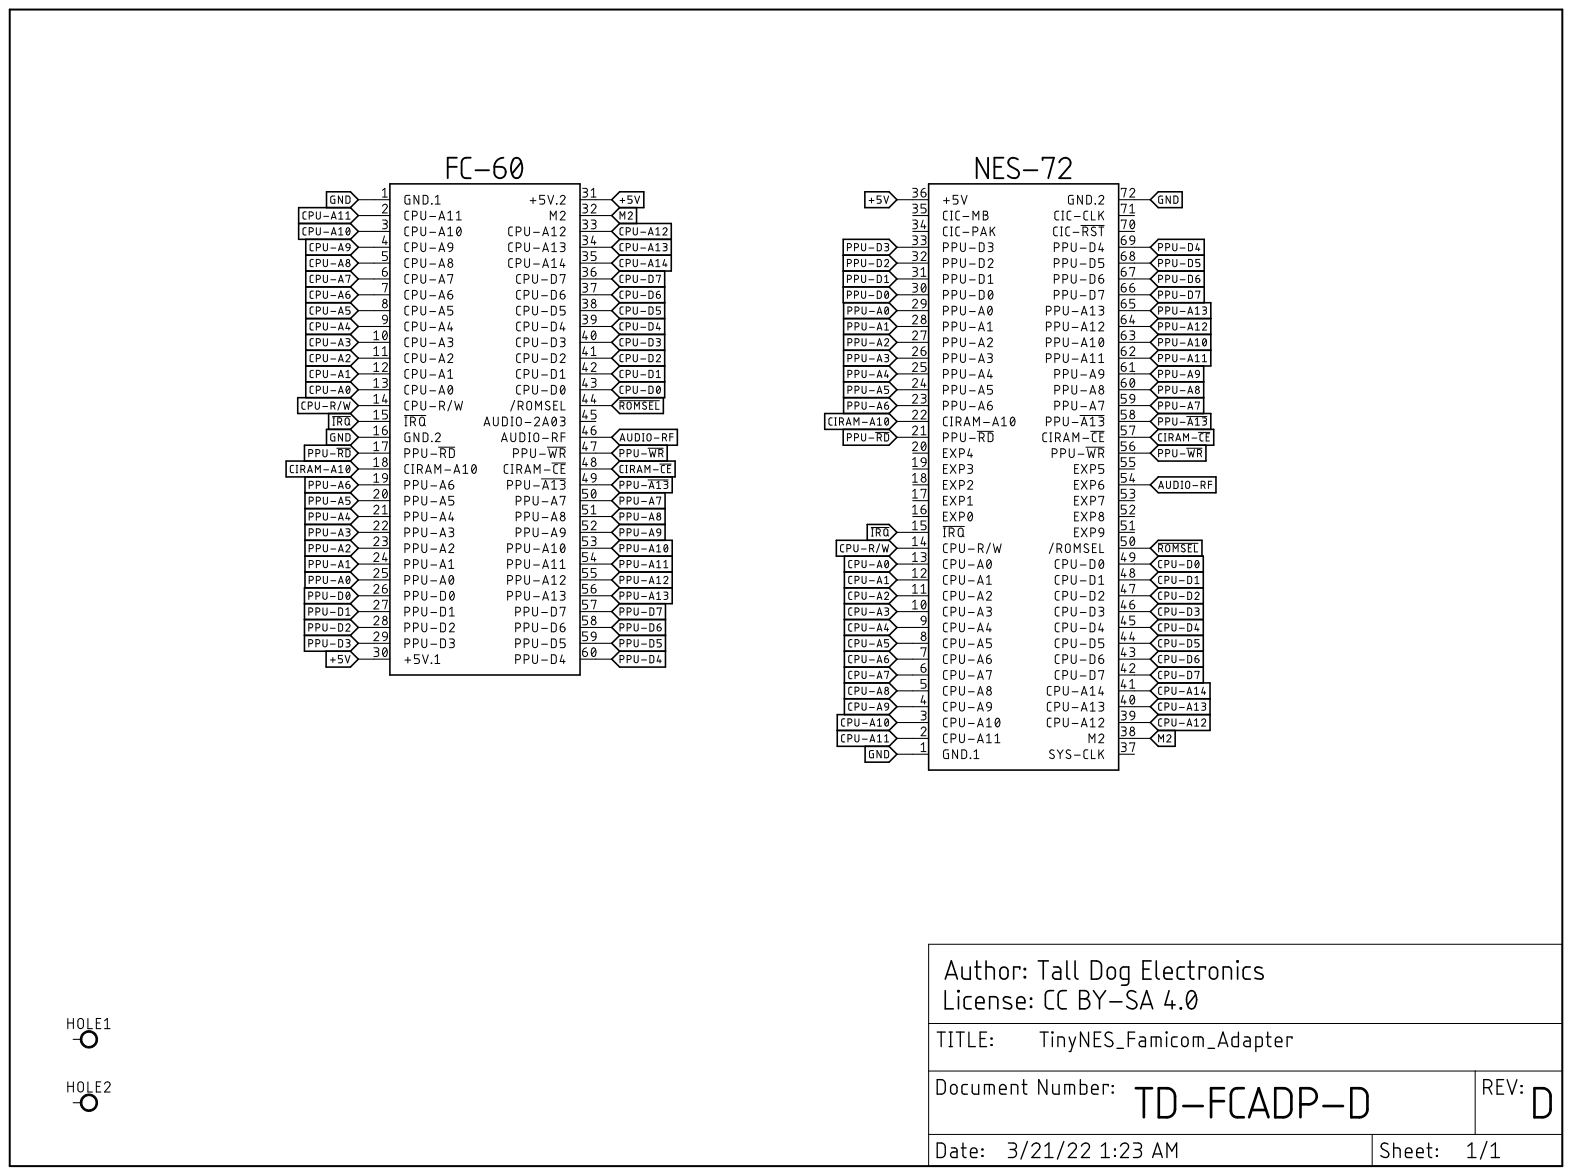
[picture p30: page 1]
