loglow/TinyNES/RGBS to YPbPr/RGBS_to_YPbPr.brd

## EAGLE design RGBS to YPbPr/RGBS_to_YPbPr.brd (2024-04-02)

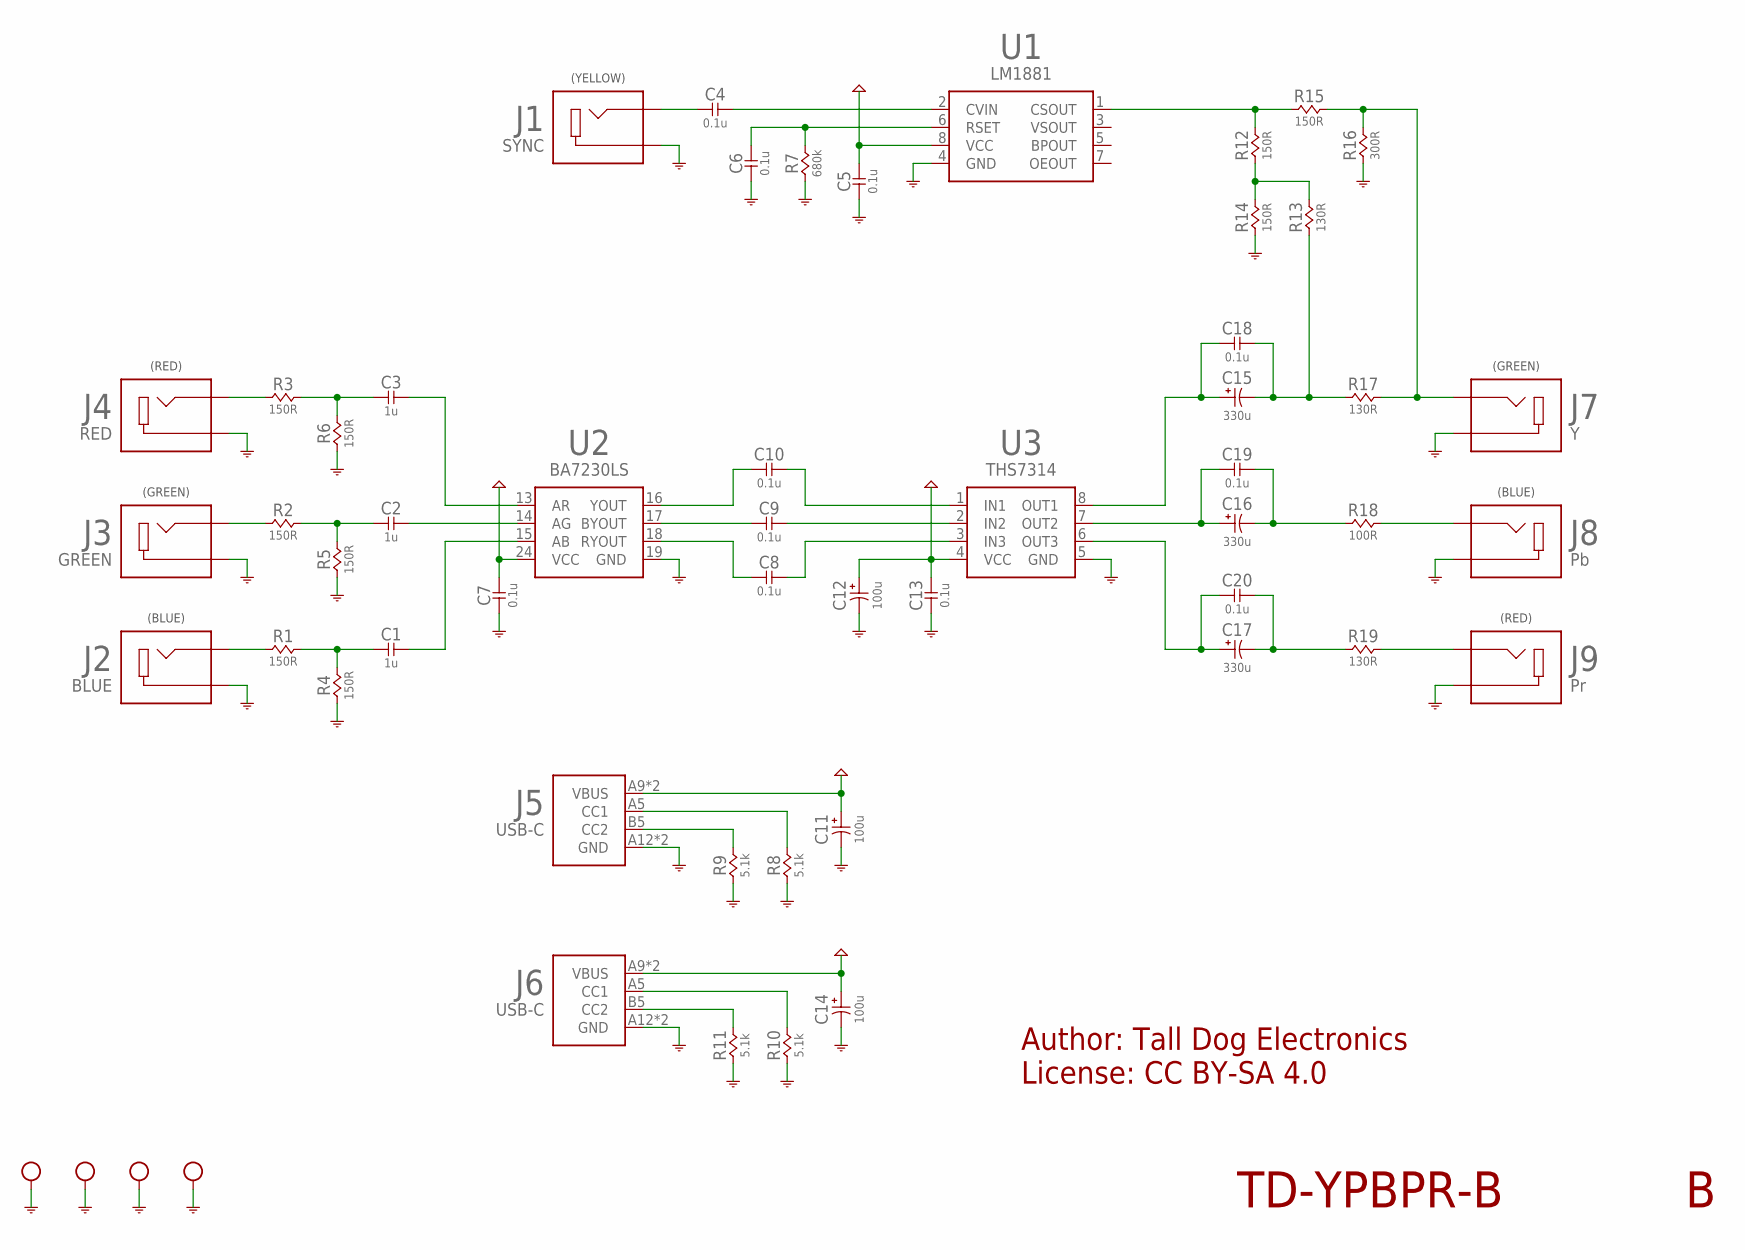
[picture p34: schematic RGBS_to_YPbPr.sch]

Parts:
C1, C2, C3: 1u; 0805-NP
C4, C5, C6, C7, C8, C9, C10, C13, C18, C19, C20: 0.1u; 0805-NP
C11, C12, C14: 100u; ECAP-D
C15, C16, C17: 330u; ECAP-E
HOLE1, HOLE2, HOLE3, HOLE4: HOLE-M2.5
J1: SYNC; RCJ
J2: BLUE; RCJ
J3: GREEN; RCJ
J4: RED; RCJ
J5, J6: USB-C; USB4125
J7: Y; RCJ
J8: Pb; RCJ
J9: Pr; RCJ
R1, R2, R3, R4, R5, R6, R12, R14, R15: 150R; 0805-NP
R7: 680k; 0805-NP
R8, R9, R10, R11: 5.1k; 0805-NP
R13, R17, R19: 130R; 0805-NP
R16: 300R; 0805-NP
R18: 100R; 0805-NP
U1: LM1881; SOIC-8
U2: BA7230LS; SZIP-24
U3: THS7314; SOIC-8

Connections:
BLUE: C1.1, R1.2, R4.2
GND: C5.1, C6.1, C7.1, C11.C, C12.C, C13.1, C14.C, HOLE1.P$1, HOLE1.P$6, HOLE1.P$7, HOLE1.P$8, HOLE1.P$9, HOLE1.P$13, HOLE1.P$14, HOLE1.P$15, HOLE1.P$16, HOLE2.P$1, HOLE2.P$6, HOLE2.P$7, HOLE2.P$8, HOLE2.P$9, HOLE2.P$13, HOLE2.P$14, HOLE2.P$15, HOLE2.P$16, HOLE3.P$1, HOLE3.P$6, HOLE3.P$7, HOLE3.P$8, HOLE3.P$9, HOLE3.P$13, HOLE3.P$14, HOLE3.P$15, HOLE3.P$16, HOLE4.P$1, HOLE4.P$6, HOLE4.P$7, HOLE4.P$8, HOLE4.P$9, HOLE4.P$13, HOLE4.P$14, HOLE4.P$15, HOLE4.P$16, J1.1B (S), J1.1T (S), J2.1B (S), J2.1T (S), J3.1B (S), J3.1T (S), J4.1B (S), J4.1T (S), J5.A12 (GND), J5.B12 (GND), J6.A12 (GND), J6.B12 (GND), J7.1B (S), J7.1T (S), J8.1B (S), J8.1T (S), J9.1B (S), J9.1T (S), R4.1, R5.1, R6.1, R7.1, R8.1, R9.1, R10.1, R11.1, R14.1, R16.1, U1.4 (GND), U2.19 (GND), U3.5 (GND)
GREEN: C2.1, R2.2, R5.2
unnamed: J7.2B (T), J7.2T (T), R15.2, R16.2, R17.2
unnamed: C16.C, C19.2, R18.1
unnamed: C16.A, C19.1, U3.7 (OUT2)
unnamed: C15.A, C18.1, U3.8 (OUT1)
unnamed: C17.C, C20.2, R19.1
unnamed: C17.A, C20.1, U3.6 (OUT3)
unnamed: C4.2, U1.2 (CVIN)
unnamed: C10.2, U3.1 (IN1)
unnamed: C9.2, U3.2 (IN2)
unnamed: C8.2, U3.3 (IN3)
unnamed: J6.B5 (CC2), R11.2
unnamed: J6.A5 (CC1), R10.2
unnamed: J5.B5 (CC2), R9.2
unnamed: J5.A5 (CC1), R8.2
unnamed: C8.1, U2.18 (RYOUT)
unnamed: J4.2B (T), J4.2T (T), R3.1
unnamed: J3.2B (T), J3.2T (T), R2.1
unnamed: C15.C, C18.2, R13.1, R17.1
unnamed: C9.1, U2.17 (BYOUT)
unnamed: J2.2B (T), J2.2T (T), R1.1
unnamed: C10.1, U2.16 (YOUT)
unnamed: R12.1, R13.2, R14.2
unnamed: C3.2, U2.13 (AR)
unnamed: C2.2, U2.14 (AG)
unnamed: C1.2, U2.15 (AB)
unnamed: C6.2, R7.2, U1.6 (RSET)
PB: J8.2B (T), J8.2T (T), R18.2
PR: J9.2B (T), J9.2T (T), R19.2
RED: C3.1, R3.2, R6.2
SYNC: C4.1, J1.2B (T), J1.2T (T)
VCC: C5.2, C7.2, C11.A, C12.A, C13.2, C14.A, J5.A9 (VBUS), J5.B9 (VBUS), J6.A9 (VBUS), J6.B9 (VBUS), U1.8 (VCC), U2.24 (VCC), U3.4 (VCC)
Y: R12.2, R15.1, U1.1 (CSOUT)

Notes on the sheet:
TD-YPBPR-B
Author: Tall Dog Electronics License: CC BY-SA 4.0
(RED)
(GREEN)
(BLUE)
(YELLOW)

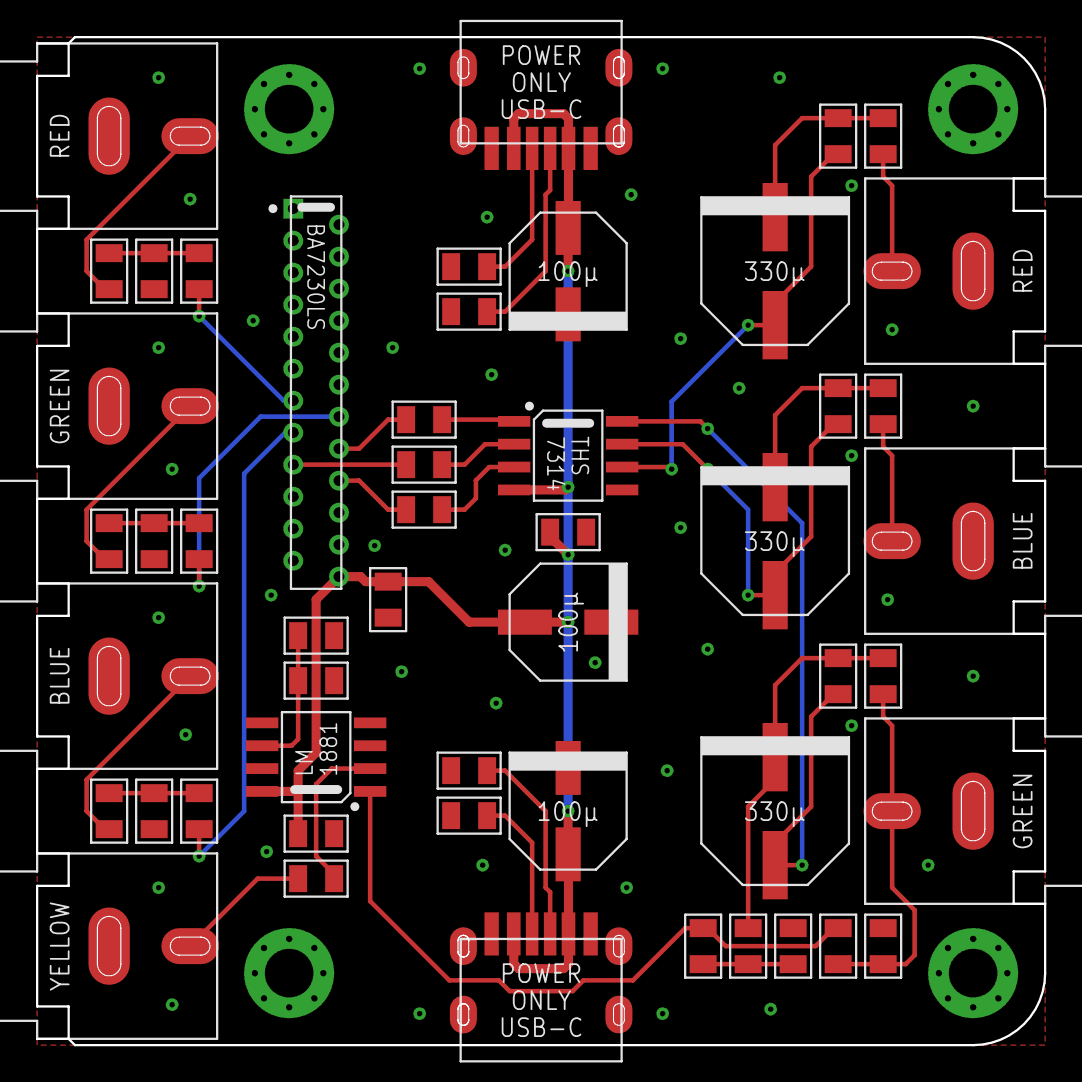
[picture p35: board RGBS_to_YPbPr.brd from above]

Board: 2 copper layers, 56.0 x 56.0 mm, 55 parts (0 on the bottom side), 35 nets.
