loglow/TinyNES/RGB Board/TinyNES_RGB_DIN_Cable.brd

## EAGLE design RGB Board/TinyNES_RGB_DIN_Cable.brd (2024-04-02)

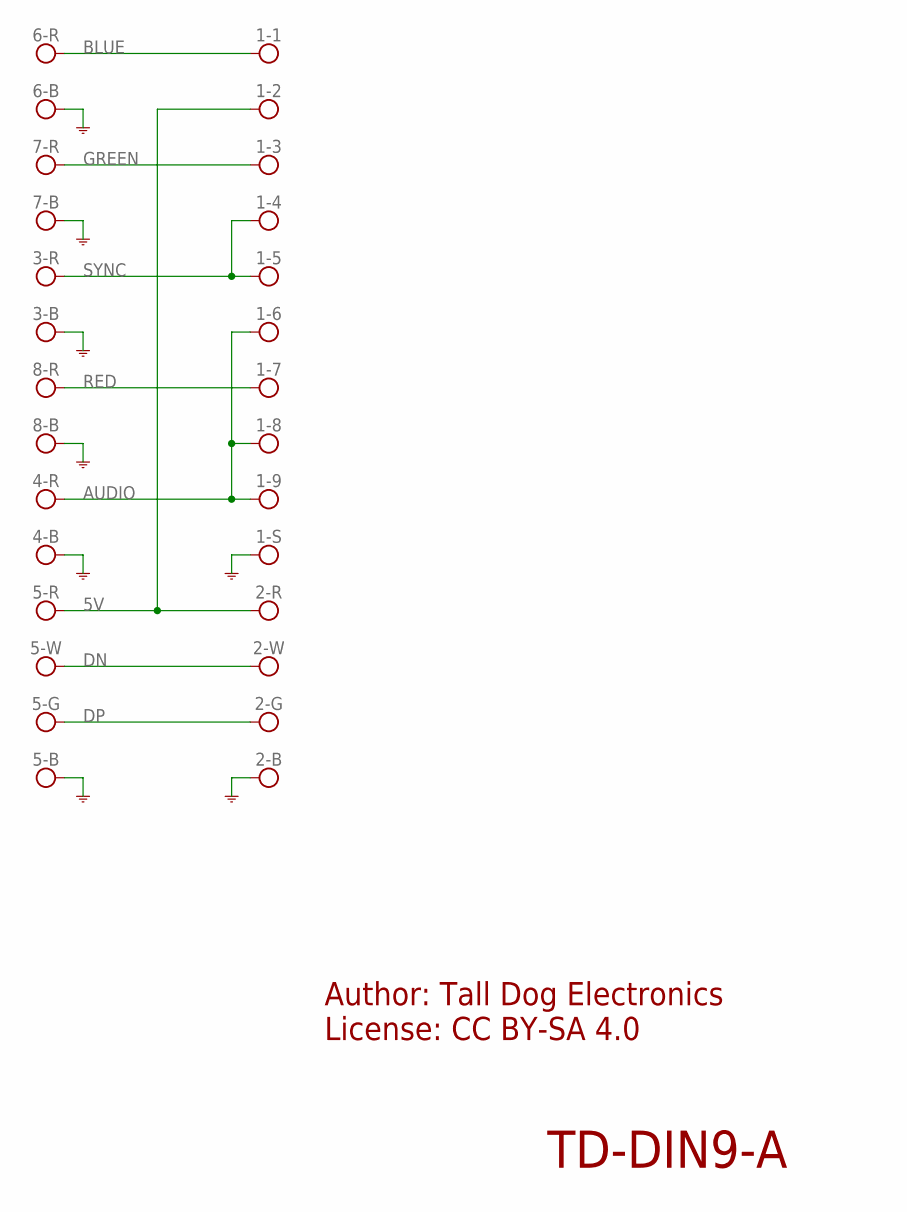
[picture p36: schematic TinyNES_RGB_DIN_Cable.sch]

Parts:
1-1, 1-2, 1-3, 1-4, 1-5, 1-6, 1-7, 1-8, 1-9, 1-S, 2-B, 2-G, 2-R, 2-W, 3-B, 3-R, 4-B, 4-R, 5-B, 5-G, 5-R, 5-W, 6-B, 6-R, 7-B, 7-R, 8-B, 8-R: HOLE-CABLE-PAD; CABLE-PAD

Connections:
5V: 1-2.P, 2-R.P, 5-R.P
AUDIO: 1-6.P, 1-8.P, 1-9.P, 4-R.P
BLUE: 1-1.P, 6-R.P
DN: 2-W.P, 5-W.P
DP: 2-G.P, 5-G.P
GND: 1-S.P, 2-B.P, 3-B.P, 4-B.P, 5-B.P, 6-B.P, 7-B.P, 8-B.P
GREEN: 1-3.P, 7-R.P
RED: 1-7.P, 8-R.P
SYNC: 1-4.P, 1-5.P, 3-R.P

Notes on the sheet:
TD-DIN9-A
Author: Tall Dog Electronics License: CC BY-SA 4.0

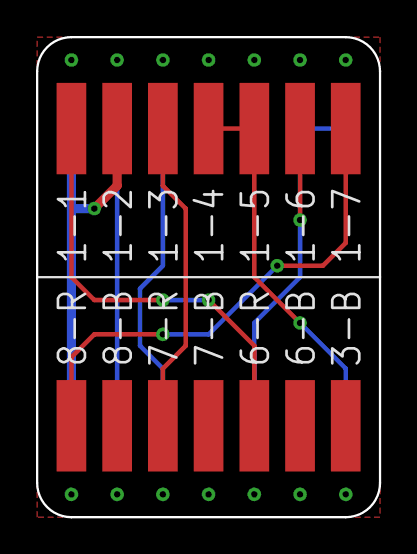
[picture p37: board TinyNES_RGB_DIN_Cable.brd from above]

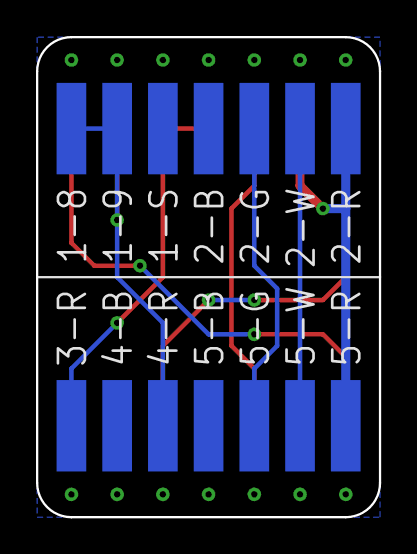
[picture p38: board TinyNES_RGB_DIN_Cable.brd from below]

Board: 2 copper layers, 19.1 x 26.7 mm, 28 parts (14 on the bottom side), 9 nets.
