loglow/TinyNES/RGB Board/TinyNES_RGB_Board.brd

## EAGLE design RGB Board/TinyNES_RGB_Board.brd (2024-04-02)

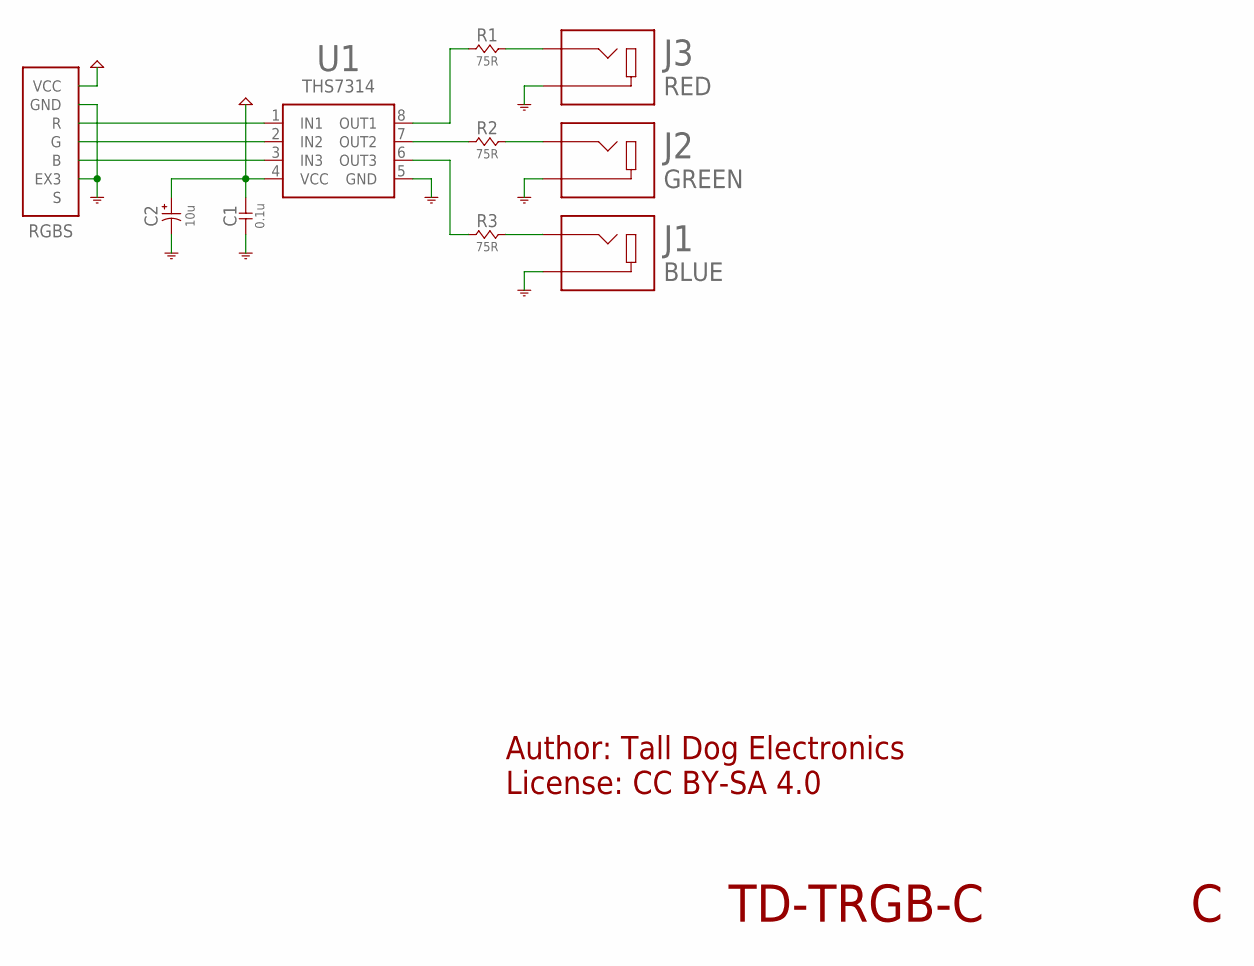
[picture p39: schematic TinyNES_RGB_Board.sch]

Parts:
C1: 0.1u; 0805-NP
C2: 10u; 1206-P
J1: BLUE; RCJ-VERT
J2: GREEN; RCJ-VERT
J3: RED; RCJ-VERT
R1, R2, R3: 75R; 0805-NP
RGBS: RGB-BOT
U1: THS7314; SOIC-8

Connections:
GND: C1.2, C2.N (C), J1.1 (S), J1.3 (S), J2.1 (S), J2.3 (S), J3.1 (S), J3.3 (S), RGBS.EXT3 (EX3), RGBS.GND, U1.5 (GND)
unnamed: RGBS.R, U1.1 (IN1)
unnamed: R3.1, U1.6 (OUT3)
unnamed: J3.2 (T), R1.2
unnamed: R1.1, U1.8 (OUT1)
unnamed: RGBS.G, U1.2 (IN2)
unnamed: RGBS.B, U1.3 (IN3)
unnamed: J2.2 (T), R2.2
unnamed: R2.1, U1.7 (OUT2)
unnamed: J1.2 (T), R3.2
VCC: C1.1, C2.P (A), RGBS.VCC@1 (VCC), RGBS.VCC@2 (VCC), RGBS.VCC@3 (VCC), U1.4 (VCC)

Notes on the sheet:
TD-TRGB-C
Author: Tall Dog Electronics License: CC BY-SA 4.0

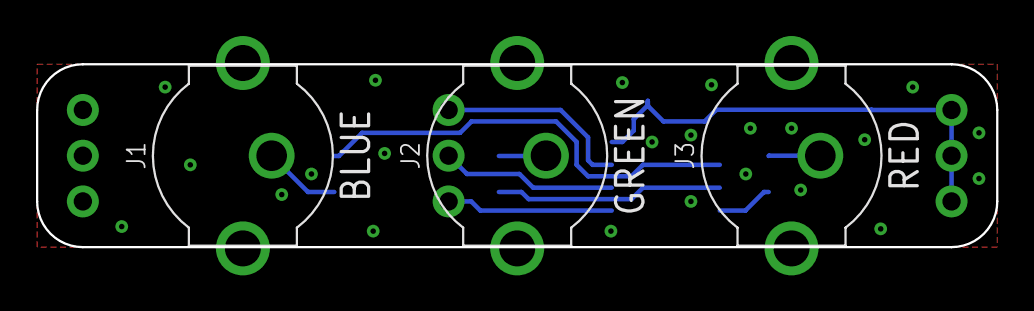
[picture p40: board TinyNES_RGB_Board.brd from above]

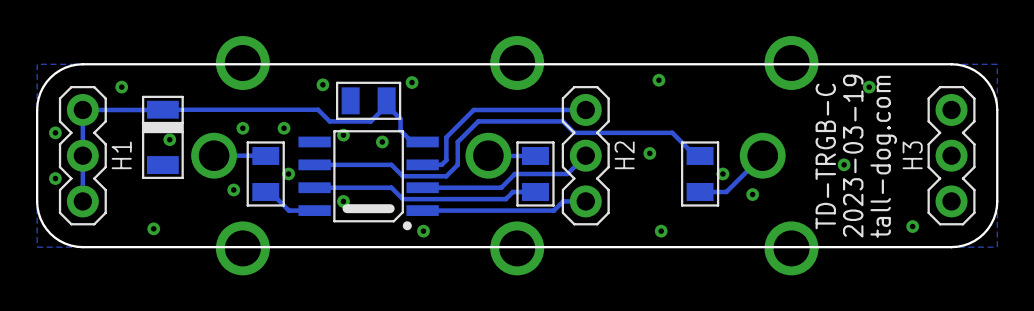
[picture p41: board TinyNES_RGB_Board.brd from below]

Board: 2 copper layers, 53.3 x 10.2 mm, 10 parts (6 on the bottom side), 11 nets.
