loglow/TinyNES/Famicom Adapter/TinyNES_Famicom_Adapter.brd

## EAGLE design Famicom Adapter/TinyNES_Famicom_Adapter.brd (2024-04-02)

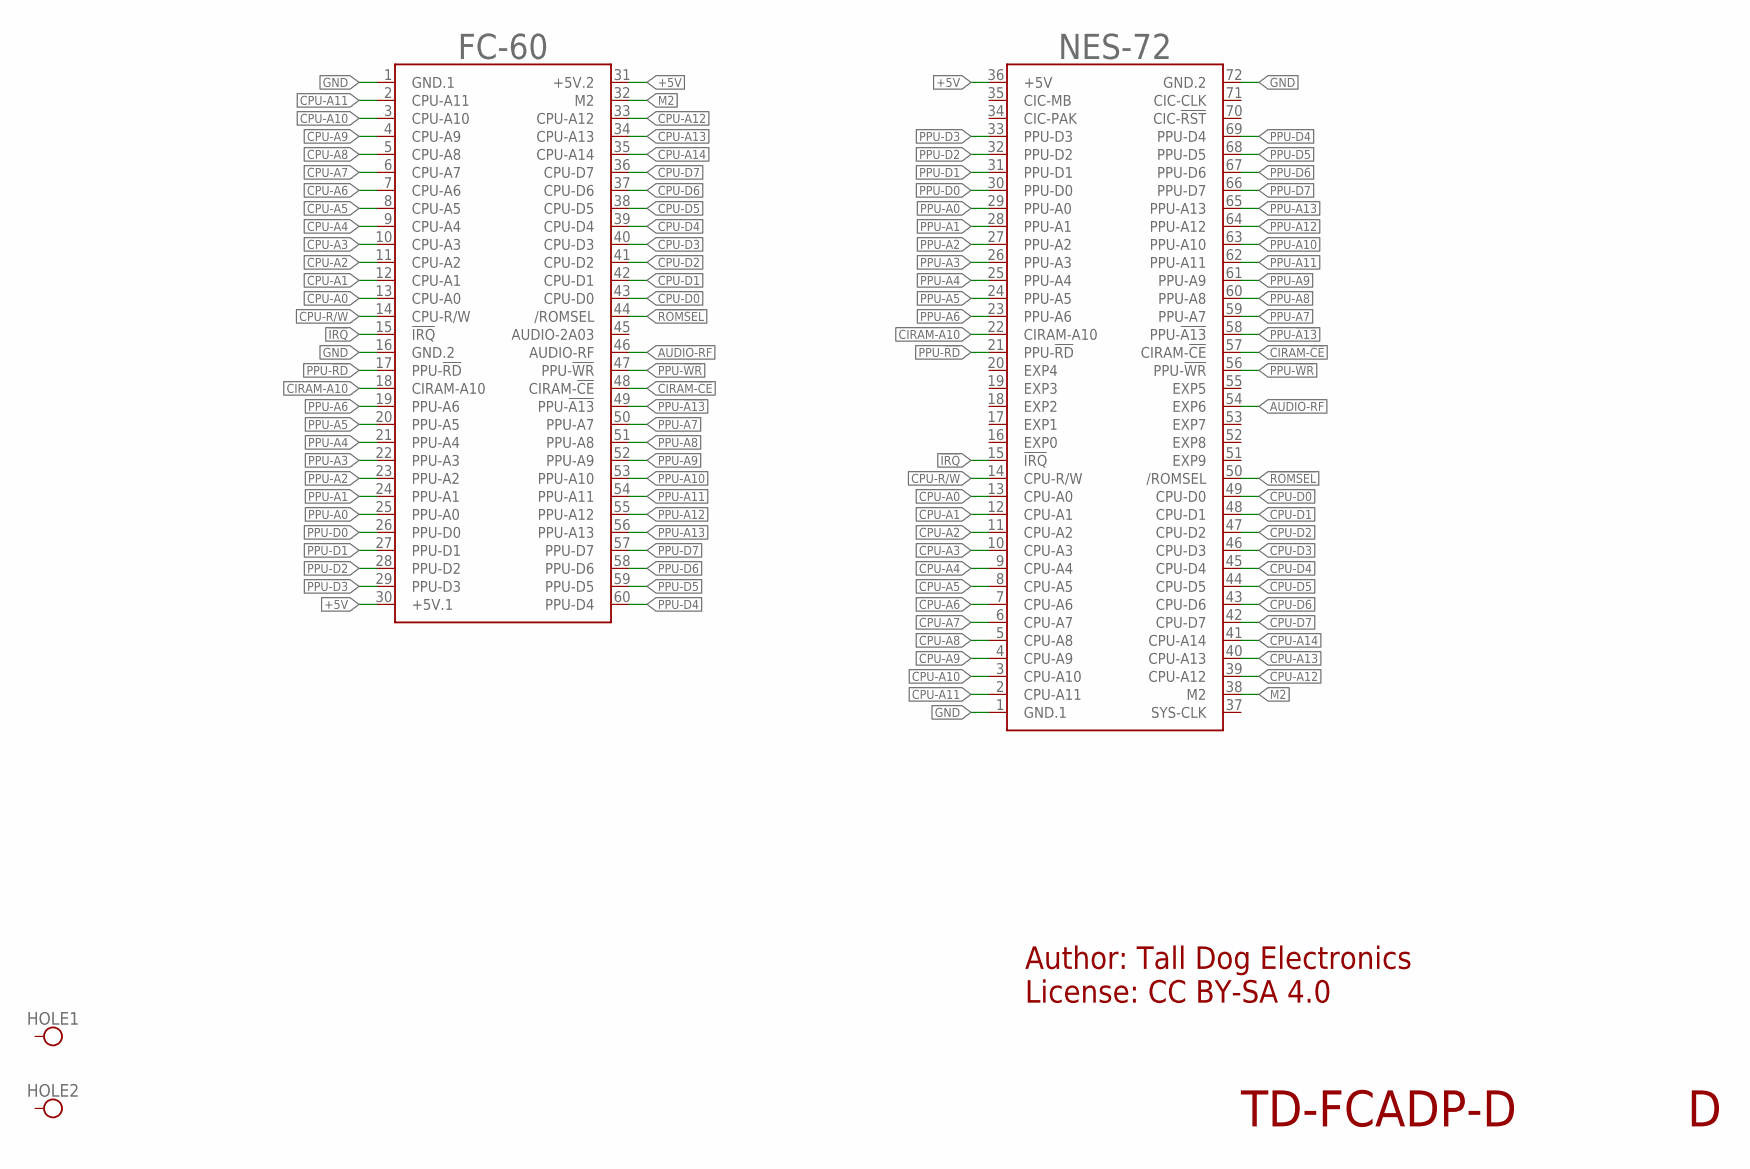
[picture p42: schematic TinyNES_Famicom_Adapter.sch]

Parts:
FC-60: CART-60-NAMES-CONN-EDGE; CART-60-2.54-CONN-EDGE
HOLE1, HOLE2: HOLE-M2.5
NES-72: CART-72-NAMES-GOLD-FINGERS; CART-72-2.50-GOLD-FINGERS

Connections:
!IRQ: FC-60.15 (!IRQ), NES-72.15 (!IRQ)
!ROMSEL: FC-60.44 (/ROMSEL), NES-72.50 (/ROMSEL)
+5V: FC-60.30 (+5V.1), FC-60.31 (+5V.2), NES-72.36 (+5V)
AUDIO-RF: FC-60.46 (AUDIO-RF), NES-72.54 (EXP6)
CIRAM-!CE: FC-60.48 (CIRAM-!CE), NES-72.57 (CIRAM-!CE)
CIRAM-A10: FC-60.18 (CIRAM-A10), NES-72.22 (CIRAM-A10)
CPU-A0: FC-60.13 (CPU-A0), NES-72.13 (CPU-A0)
CPU-A1: FC-60.12 (CPU-A1), NES-72.12 (CPU-A1)
CPU-A2: FC-60.11 (CPU-A2), NES-72.11 (CPU-A2)
CPU-A3: FC-60.10 (CPU-A3), NES-72.10 (CPU-A3)
CPU-A4: FC-60.9 (CPU-A4), NES-72.9 (CPU-A4)
CPU-A5: FC-60.8 (CPU-A5), NES-72.8 (CPU-A5)
CPU-A6: FC-60.7 (CPU-A6), NES-72.7 (CPU-A6)
CPU-A7: FC-60.6 (CPU-A7), NES-72.6 (CPU-A7)
CPU-A8: FC-60.5 (CPU-A8), NES-72.5 (CPU-A8)
CPU-A9: FC-60.4 (CPU-A9), NES-72.4 (CPU-A9)
CPU-A10: FC-60.3 (CPU-A10), NES-72.3 (CPU-A10)
CPU-A11: FC-60.2 (CPU-A11), NES-72.2 (CPU-A11)
CPU-A12: FC-60.33 (CPU-A12), NES-72.39 (CPU-A12)
CPU-A13: FC-60.34 (CPU-A13), NES-72.40 (CPU-A13)
CPU-A14: FC-60.35 (CPU-A14), NES-72.41 (CPU-A14)
CPU-D0: FC-60.43 (CPU-D0), NES-72.49 (CPU-D0)
CPU-D1: FC-60.42 (CPU-D1), NES-72.48 (CPU-D1)
CPU-D2: FC-60.41 (CPU-D2), NES-72.47 (CPU-D2)
CPU-D3: FC-60.40 (CPU-D3), NES-72.46 (CPU-D3)
CPU-D4: FC-60.39 (CPU-D4), NES-72.45 (CPU-D4)
CPU-D5: FC-60.38 (CPU-D5), NES-72.44 (CPU-D5)
CPU-D6: FC-60.37 (CPU-D6), NES-72.43 (CPU-D6)
CPU-D7: FC-60.36 (CPU-D7), NES-72.42 (CPU-D7)
CPU-R/W: FC-60.14 (CPU-R/W), NES-72.14 (CPU-R/W)
GND: FC-60.1 (GND.1), FC-60.16 (GND.2), NES-72.1 (GND.1), NES-72.72 (GND.2)
M2: FC-60.32 (M2), NES-72.38 (M2)
PPU-!A13: FC-60.49 (PPU-!A13), NES-72.58 (PPU-!A13)
PPU-!RD: FC-60.17 (PPU-!RD), NES-72.21 (PPU-!RD)
PPU-!WR: FC-60.47 (PPU-!WR), NES-72.56 (PPU-!WR)
PPU-A0: FC-60.25 (PPU-A0), NES-72.29 (PPU-A0)
PPU-A1: FC-60.24 (PPU-A1), NES-72.28 (PPU-A1)
PPU-A2: FC-60.23 (PPU-A2), NES-72.27 (PPU-A2)
PPU-A3: FC-60.22 (PPU-A3), NES-72.26 (PPU-A3)
PPU-A4: FC-60.21 (PPU-A4), NES-72.25 (PPU-A4)
PPU-A5: FC-60.20 (PPU-A5), NES-72.24 (PPU-A5)
PPU-A6: FC-60.19 (PPU-A6), NES-72.23 (PPU-A6)
PPU-A7: FC-60.50 (PPU-A7), NES-72.59 (PPU-A7)
PPU-A8: FC-60.51 (PPU-A8), NES-72.60 (PPU-A8)
PPU-A9: FC-60.52 (PPU-A9), NES-72.61 (PPU-A9)
PPU-A10: FC-60.53 (PPU-A10), NES-72.63 (PPU-A10)
PPU-A11: FC-60.54 (PPU-A11), NES-72.62 (PPU-A11)
PPU-A12: FC-60.55 (PPU-A12), NES-72.64 (PPU-A12)
PPU-A13: FC-60.56 (PPU-A13), NES-72.65 (PPU-A13)
PPU-D0: FC-60.26 (PPU-D0), NES-72.30 (PPU-D0)
PPU-D1: FC-60.27 (PPU-D1), NES-72.31 (PPU-D1)
PPU-D2: FC-60.28 (PPU-D2), NES-72.32 (PPU-D2)
PPU-D3: FC-60.29 (PPU-D3), NES-72.33 (PPU-D3)
PPU-D4: FC-60.60 (PPU-D4), NES-72.69 (PPU-D4)
PPU-D5: FC-60.59 (PPU-D5), NES-72.68 (PPU-D5)
PPU-D6: FC-60.58 (PPU-D6), NES-72.67 (PPU-D6)
PPU-D7: FC-60.57 (PPU-D7), NES-72.66 (PPU-D7)

Notes on the sheet:
TD-FCADP-D
Author: Tall Dog Electronics License: CC BY-SA 4.0

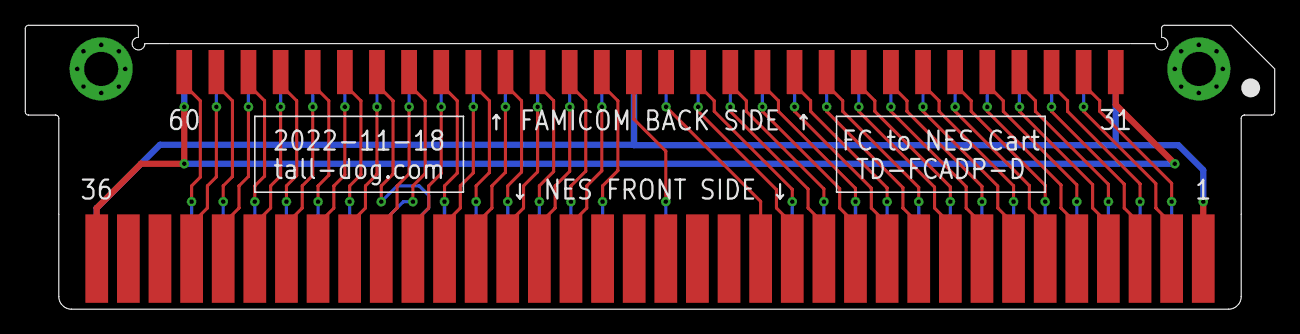
[picture p43: board TinyNES_Famicom_Adapter.brd from above]

Board: 2 copper layers, 98.8 x 22.4 mm, 4 parts (1 on the bottom side), 57 nets.
