loglow/TinyNES/Controller Port/TinyNES_Controller_Port.brd

## EAGLE design Controller Port/TinyNES_Controller_Port.brd (2024-04-02)

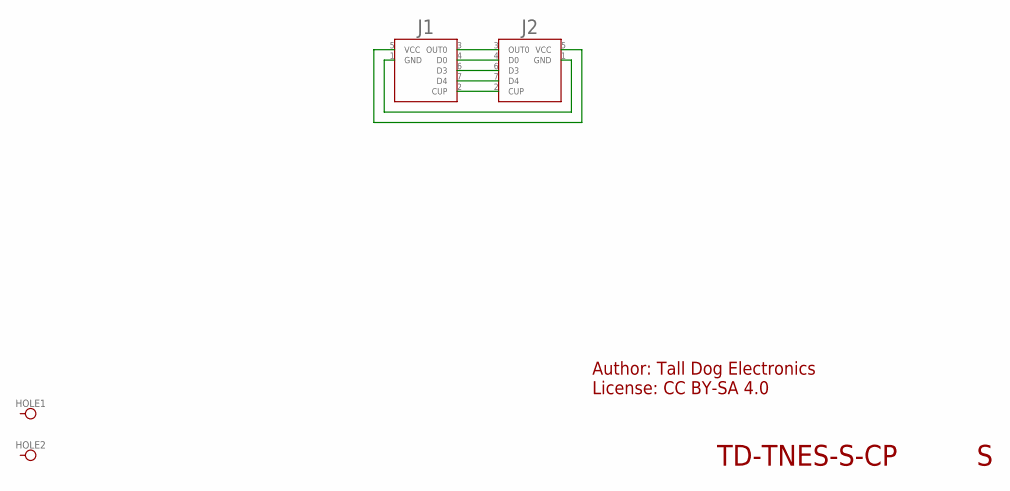
[picture p44: schematic TinyNES_Controller_Port.sch]

Parts:
HOLE1, HOLE2: HOLE-M2.5
J1: CTRL; JST-PH-7
J2: CTRL-NES; NES-CTRL

Connections:
CUP: J1.2 (CUP), J2.2 (CUP)
D0: J1.4 (D0), J2.4 (D0)
D3: J1.6 (D3), J2.6 (D3)
D4: J1.7 (D4), J2.7 (D4)
GND: J1.1 (GND), J2.1 (GND)
OUT0: J1.3 (OUT0), J2.3 (OUT0)
VCC: J1.5 (VCC), J2.5 (VCC)

Notes on the sheet:
TD-TNES-S-CP
Author: Tall Dog Electronics License: CC BY-SA 4.0

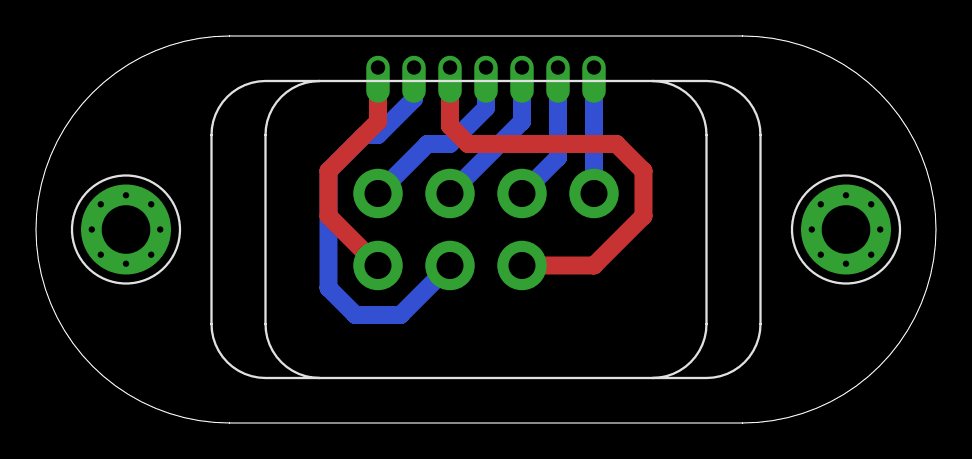
[picture p45: board TinyNES_Controller_Port.brd from above]

Board: 2 copper layers, 50.0 x 21.5 mm, 4 parts (1 on the bottom side), 7 nets.
