loglow/TinyNES/Controller Board/NES_Controller_Board.brd

## EAGLE design Controller Board/NES_Controller_Board.brd (2022-03-21)

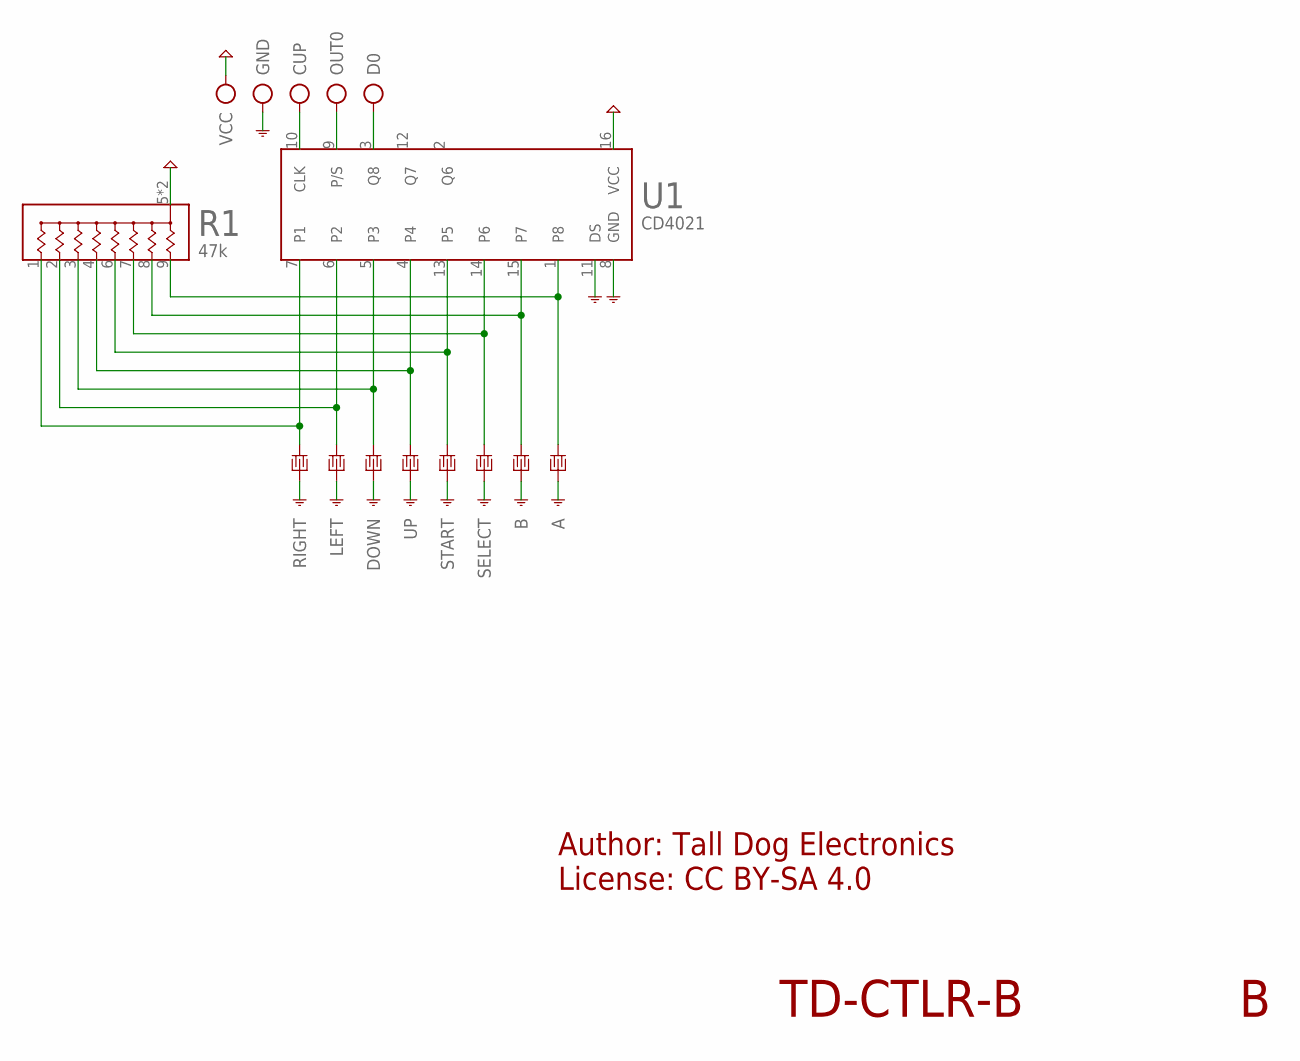
[picture p46: schematic NES_Controller_Board.sch]

Parts:
A: BUTTON-PAD-AB; CTRL-AB
B: BUTTON-PAD-AB; CTRL-AB
CUP: 2/RD; PTH-STRAIN
D0: 4/YL; PTH-STRAIN
DOWN: BUTTON-PAD-DPAD; CTRL-DPAD
GND: 1/BN; PTH-STRAIN
LEFT: BUTTON-PAD-DPAD; CTRL-DPAD
OUT0: 3/OR; PTH-STRAIN
R1: 47k; EXBA10P
RIGHT: BUTTON-PAD-DPAD; CTRL-DPAD
SELECT: BUTTON-PAD-STSEL; CTRL-STSEL
START: BUTTON-PAD-STSEL; CTRL-STSEL
U1: CD4021; SOIC-16
UP: BUTTON-PAD-DPAD; CTRL-DPAD
VCC: 5/WH; PTH-STRAIN

Connections:
CUP: CUP.A, CUP.P, U1.10 (CLK)
D0: D0.A, D0.P, U1.3 (Q8)
GND: A.A, B.A, DOWN.A, GND.A, GND.P, LEFT.A, RIGHT.A, SELECT.A, START.A, U1.8 (GND), U1.11 (DS), UP.A
unnamed: LEFT.B, R1.2, U1.6 (P2)
unnamed: R1.4, U1.4, UP.B
unnamed: DOWN.B, R1.3, U1.5 (P3)
unnamed: R1.1, RIGHT.B, U1.7 (P1)
unnamed: R1.6 (5), START.B, U1.13 (P5)
unnamed: R1.7 (6), SELECT.B, U1.14 (P6)
unnamed: B.B, R1.8 (7), U1.15 (P7)
unnamed: A.B, R1.9 (8), U1.1 (P8)
OUT0: OUT0.A, OUT0.P, U1.9 (P/S)
VCC: R1.5 (COM), R1.10 (COM), U1.16 (VCC), VCC.A, VCC.P

Notes on the sheet:
TD-CTLR-B
Author: Tall Dog Electronics License: CC BY-SA 4.0

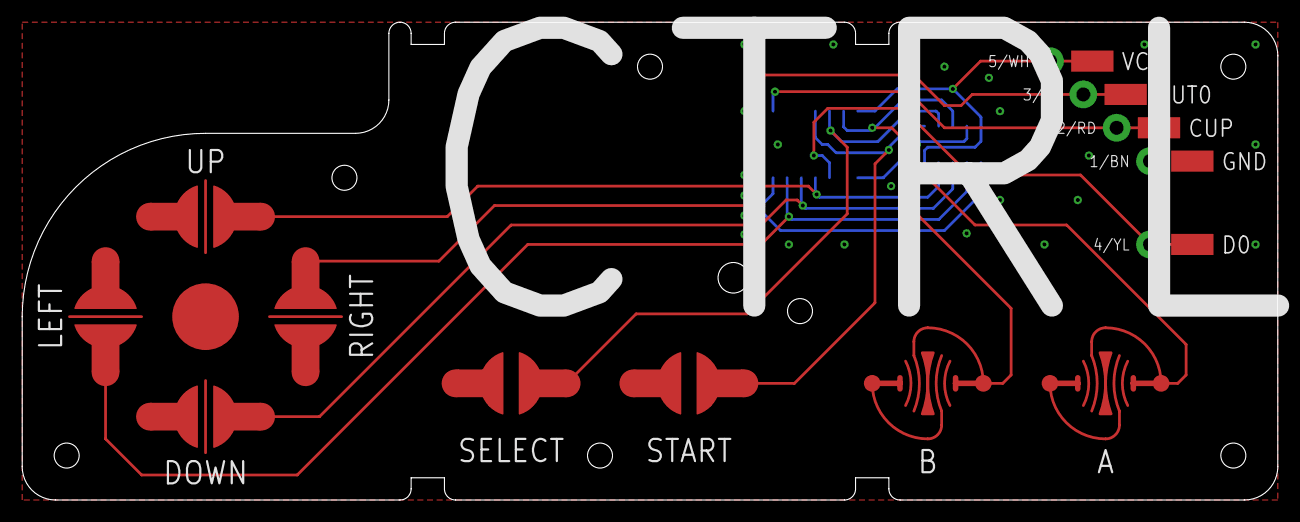
[picture p47: board NES_Controller_Board.brd from above]

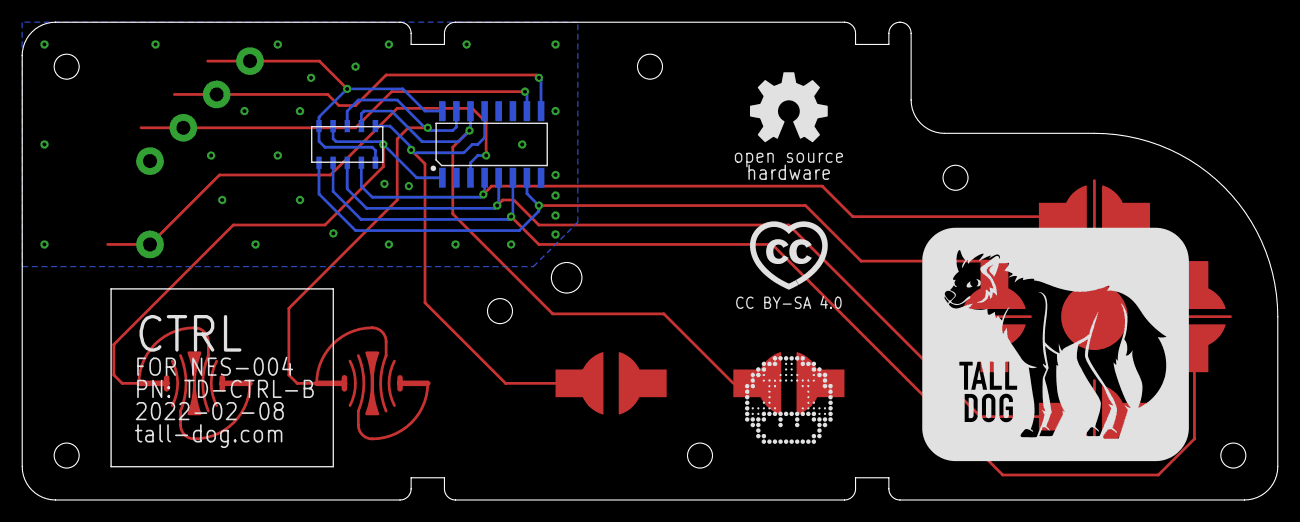
[picture p48: board NES_Controller_Board.brd from below]

Board: 2 copper layers, 113.0 x 43.0 mm, 19 parts (11 on the bottom side), 13 nets.

Other parts of the board:
U$1: _LOGO-TALL-DOG
U$2: _PIXEL-ART-1UP
U$3: _LOGO-OSH
U$4: _LOGO-CC-BY-SA
