loglow/TinyNES/(commit log)

2022-03-21 first commit of all project files
    [NES_Controller_Board.brd, NES_Controller_Board.sch, NES_Controller_Board_BOM.csv, NES_Controller_Board_Model.skp, NES_Controller_Board_XYR.csv, TinyNES_Cart_Guide.f3d, TinyNES_Cart_Guide.step, TinyNES_Cart_Latch_Body.f3d]
2022-03-24 Added OSHWA cert number
    [TinyNES_Enclosure_Bottom.brd]
2022-07-28 Main board revisions for production version
    [TinyNES_Main_Board.brd, TinyNES_Main_Board.sch, TinyNES_Main_Board_BOM.csv, TinyNES_Main_Board_XYR.csv]
2022-07-28 Prep for RGB board option
    [TinyNES_Enclosure_Top_RGB.brd, TinyNES_PCB_Specs.csv, TinyNES_RGB_Spacer.stl]
2022-10-26 Minor cleanup
    [TinyNES_Main_Board.brd, TinyNES_Main_Board.sch, TinyNES_Main_Board_BOM.csv]
2024-04-02 enclosure date and version update
    [TinyNES_Enclosure_Bottom.brd, TinyNES_Enclosure_Front.brd, TinyNES_Enclosure_Rear.brd, TinyNES_Enclosure_Side.brd, TinyNES_Enclosure_Top.brd]
2024-04-02 controller port date update
    [TinyNES_Controller_Port.brd]
2024-04-02 famicom adapter date update
    [TinyNES_Famicom_Adapter.brd]
2024-04-02 added jumper board files
    [TinyNES_Jumper_Board.brd, TinyNES_Jumper_Board.sch, TinyNES_Jumper_Board_BOM.csv]
2024-04-02 updated labels with new version
    [TinyNES_Cart_Latch_Label.brd, TinyNES_Famicom_Adapter_Label.brd]
2024-04-02 main board version updates
    [TinyNES_J3_Spacer.brd, TinyNES_Main_Board.brd, TinyNES_Main_Board.sch, TinyNES_Main_Board_BOM.csv, TinyNES_Main_Board_XYR.csv]
2024-04-02 plastic part revisions
    [TinyNES_Cart_Latch_Body.f3d, TinyNES_Cart_Latch_Body.step, TinyNES_Cart_Latch_Lever.f3d, TinyNES_Cart_Latch_Lever_Left.step, TinyNES_Cart_Latch_Lever_Right.step, TinyNES_Famicom_Adapter.f3d, TinyNES_Famicom_Adapter_Back.step, TinyNES_Famicom_Adapter_Front.step]
2024-04-02 added RGB board files
    [TinyNES_RGB_Board.brd, TinyNES_RGB_Board.sch, TinyNES_RGB_Board_BOM.csv, TinyNES_RGB_Board_XYR.csv, TinyNES_RGB_DIN_Cable.brd, TinyNES_RGB_DIN_Cable.sch]
2024-04-02 added RGBS to YPbPr adapter files
    [RGBS_to_YPbPr.brd, RGBS_to_YPbPr.sch, RGBS_to_YPbPr_BOM.csv, RGBS_to_YPbPr_Enclosure_Bottom.stl, RGBS_to_YPbPr_Enclosure_Top.stl, RGBS_to_YPbPr_Model.skp, RGBS_to_YPbPr_XYR.csv]
2024-04-02 updated base files for new revision
    [TinyNES_PCB_Specs.csv]
2024-07-05 Updates in preparation for next production run (Main Board Rev 27)
    [TinyNES_Main_Board.brd, TinyNES_Main_Board.sch, TinyNES_Main_Board_BOM.csv, TinyNES_Main_Board_XYR.csv]
2024-07-20 small part change update
    [TinyNES_Main_Board_BOM.csv]
2024-07-26 minor resistor component value change
    [TinyNES_Main_Board.brd, TinyNES_Main_Board.sch, TinyNES_Main_Board_BOM.csv]
