loglow/TinyNES/(notices)

Notices in the files:
Enclosure/TinyNES_Enclosure_Bottom.brd:
More info at: creativecommons.org
